bracino/bracino/server/README.md

# server

Self-hosted supervision stack — **t520 backend** (HP t520, 192.168.1.215, issue 015 stage A).

Recovery path: `git clone && docker compose up` (after the one-time steps below).

## Design (2026-09-05, settled)

- **Capture chain:** mosquitto → commit service → JSONL. BATCH_ACK is gated on **fsync'd JSONL** only. InfluxDB (stage C) is a *projection*: written by a tailer, never gates acks, always rebuildable from JSONL.
- **Storage, three failure domains:**

| Store | Location | Role |
|---|---|---|
| live JSONL | t520 local `/var/lib/bracino/commit` (30-day rotation, stage C) | source of truth; ack path depends on nothing external |
| JSONL mirror | `/mnt/nas-data2/bracino/commit` (daily rsync) | recovery copy, second failure domain |
| InfluxDB | `/mnt/nas-data1/bracino/influx` | queryable store; UI on :8086 for desktop/Grafana |

- **Auth:** single shared MQTT user `bracino` (hashed `passwd` file, gitignored; plaintext only in `server/.env` (gitignored) and the gateway's NVS via `/prov`). Plaintext 1883 on the LAN is proportionate; per-user ACLs are the upgrade path.
- **Health:** `bracino/gateway/health` = **commit path only** (broker seen, JSONL writable, heartbeating). Influx gets its own topic in stage C — an Influx failure must never gate ESP-NOW.

## Files

| Path | What |
|---|---|
| `docker-compose.yml` | mosquitto + commit (always); influxdb behind `--profile influx` (stage C) |
| `mosquitto/mosquitto.conf` | broker config: auth required, persistence on (DN004) |
| `mosquitto/passwd` | hashed credentials — **gitignored, generated on host** |
| `commit-service/` | DN005 service + Dockerfile + fake_publisher (bench) |

## t520 bring-up (stage B)

### 0. Prereqs

```bash
git clone git@github.com:bracino/bracino.git ~/bracino && cd ~/bracino/server
findmnt | grep -E 'nas-data[12]'      # both drives durably mounted
ip addr | grep 192.168.1.215          # DHCP reservation live
docker run --rm hello-world
```

### 1. Directory skeleton

```bash
sudo mkdir -p /mnt/nas-data1/bracino/{mosquitto/{data,log},influx/{data,config}}
sudo mkdir -p /mnt/nas-data2/bracino/commit
sudo chown -R 1883:1883 /mnt/nas-data1/bracino/mosquitto
sudo chown -R 1000:1000 /mnt/nas-data1/bracino/influx /mnt/nas-data2/bracino/commit
sudo mkdir -p /var/lib/bracino/commit && sudo chown 1000:1000 /var/lib/bracino/commit
```

### 2. Broker auth

```bash
docker run -it --rm -v "$PWD/mosquitto:/mosquitto/config" eclipse-mosquitto:2 \
  mosquitto_passwd -c /mosquitto/config/passwd bracino
# ↑ -it required: without stdin attach, passwd reads EOF → "Empty password"
sudo chown 1883:1883 mosquitto/passwd
ls -l mosquitto/passwd      # -rw------- ... 1883 1883 — 0600 is what we want
sudo cat mosquitto/passwd   # expect: bracino:$7$… (hash, not plaintext)
# plain `cat` denies you on purpose; only the broker (uid 1883) reads it
```

### 3. Secrets

```bash
cat > .env << 'EOF'
MQTT_USER=bracino
MQTT_PASS=<your password>
EOF
chmod 600 .env
```

### 4. Up + smoke test

```bash
docker compose up -d mosquitto commit
docker compose logs --tail 20 commit     # connected, subscribed
# docker compose auto-loads .env; your shell does not — export first
set -a; . ./.env; set +a
mosquitto_sub -h localhost -t 'bracino/#' -u bracino -P "$MQTT_PASS" -v &
mosquitto_pub -h localhost -t 'bracino/test' -m ping -u bracino -P "$MQTT_PASS"
```

### 5. Daily JSONL mirror (install once)

```bash
( crontab -l 2>/dev/null; \
  echo '17 3 * * * rsync -a --delete /var/lib/bracino/commit/ /mnt/nas-data2/bracino/commit/' ) | crontab -
```

## Gateway provisioning (after stage B)

Flash from the dev VM (`idf.py -p /dev/ttyACM1 flash monitor`), long-press GPIO27 → join `bracino-gateway01`/`bracinoAdmin` → `http://192.168.5.1/prov`: house WiFi, broker `192.168.1.215:1883`, **MQTT user `bracino` + password**. Serial fallback: `u <user> [pass]` (or `u -` to clear). Status page shows the user, never the password.

## Stage C (influx), deployed 2026-09-08

InfluxDB runs behind `--profile influx`; the **tailer** in commit-service
projects the JSONL into it. Facts:

- **Ack path untouched:** the tailer is a daemon thread that reads the
  JSONL and POSTs line protocol to `INFLUX_URL`. Its failures never
  touch watermarks, acks, alarms or the MQTT loop. JSONL stays the
  source of truth; the projection is rebuildable by deleting
  `/var/lib/bracino/commit/influx_tail.json` and restarting (re-tail is
  idempotent — timestamps come from each record's own stamp, so overlap
  overwrites identical points).
- **Gating:** set `INFLUX_TOKEN` in `server/.env` to enable; unset =
  pre-stage-C behavior. `INFLUX_URL` defaults to `http://influxdb:8086`
  (compose DNS); org/bucket default to `bracino`.
- **First run backfills** the whole JSONL (~16k points ≈ 4.7 MB —
  seconds). Bench traffic lands too; boot_session tags separate the
  streams (see 015 record-hygiene note; AMB discount rule in 022).
- **Measurements:** `telemetry` (tags node_type/node_id/boot_session/
  mode; fields t_tpo, t_tpu, t_amb, ct_state, relay_state,
  fault_flags, capture_ms), `event` (tags node_type/node_id/event/
  fault_id), `gw_ambient` (fields t_amb, fault).
- **Health:** `bracino/backend/influx` {ok, last_write_age_s, lines}
  retained, 30 s — commit-path health stays on `bracino/gateway/health`
  and never depends on Influx.
- Note: the GW's ext-ambient channel read −31 °C (misranged) until
  2026-09-06 ~14:49Z; `gw_ambient` before that stamp is junk (see
  issue 022 discussion).

```bash
docker compose --profile influx up -d      # one-time influx deploy (done)
cd ~/bracino/server && git pull && docker compose build commit \
  && docker compose up -d commit           # enable the tailer
```

Grafana runs in the stack (profile `grafana`, port 3000, data on
`/mnt/nas-data1/bracino/grafana`; datasource + starter dashboard
provisioned from `server/grafana/` — first login is `admin`/`admin`,
Grafana forces a password change):

```bash
docker compose --profile grafana up -d      # one-time grafana deploy
```

The desktop can still browse Influx directly at `http://192.168.1.215:8086`.

### Rotation recovery (mv-style rotation)

Deleting, moving, or rotating the JSONL is always safe for the commit
path (per-line open-append-fsync-close; see commit-service README). For
the *projection* the rule is: the tailer treats `size < offset` as a
rotation and re-tails the **new** file from 0 — so a file you `mv` away
(`telemetry.jsonl.old`) is never ingested. If you rotate by `mv`, merge
the old content back into the live file **while commit is stopped** and
force a full re-tail:

```bash
cd ~/bracino/server && docker compose stop commit
cd /var/lib/bracino/commit
cat telemetry.jsonl.old telemetry.jsonl > telemetry.jsonl.merged
wc -l telemetry.jsonl.old telemetry.jsonl telemetry.jsonl.merged  # counts must add up
mv telemetry.jsonl.merged telemetry.jsonl
rm data/influx_tail.json        # force full re-tail; deletion only counts while stopped
cd ~/bracino/server && docker compose start commit
```

Re-POST of already-ingested points is harmless — timestamps come from
the records themselves, so overlap overwrites identical points. Keep
the stopped window short: unacked node batches are retransmitted and
JSONL-deduped; only QoS-1 *events* published during the gap are lost
(clean session), and alarms are retained.

**Verified 2026-09-09:** 4.4 MB rotated `.old` merged, full re-tail
clean, backfill visible in the :8086 UI matching the plotter output.

### Gotchas seen in stage B

- **Bind-mount path auto-created as a directory**: if `docker compose up`
  runs before a mounted file exists (e.g. `mosquitto/passwd`), docker
  creates the missing host path as a root-owned *directory*. Broker then
  fails with `Unable to open pwfile` forever. Fix: `rmdir` it, generate
  the file, `docker compose up -d`.
- **passwd generation needs `-it`**: without stdin attach, `mosquitto_passwd`
  reads EOF → `Empty password`.
- **passwd ownership**: generated as root:0600; chown to the image's
  broker uid (`docker run --rm eclipse-mosquitto:2 id mosquitto`).

## commit-service bench (unchanged)

The VM bench workflow (venv, fake_publisher, layer-1 drills 1–3 results) lives in [`commit-service/README.md`](commit-service/README.md). The service falls back to anonymous MQTT when `MQTT_USER`/`MQTT_PASS` are unset, so drills keep working against an auth-less bench broker.
