bracino/bracino/server/commit-service/README.md

# commit service — DN005 skeleton (issue 015)

Bench phase of the backend pipeline: subscribes gateway telemetry/events,
writes JSONL durably, publishes commit watermarks the gateway's
BATCH_ACK is gated on. Grows into the real DN005 service (Influx write)
later — the JSONL schema is the Influx mapping.

## Files

- `commit_service.py` — subscriber + JSONL writer + watermark/time/health publisher
- `fake_publisher.py` — synthetic DN004 telemetry source (layer-1 test, zero firmware)
- `data/` — runtime output, **gitignored** (`telemetry.jsonl`, `commit_state.json`)

## Run (bench)

```bash
cd server/commit-service
python3 -m venv .venv && . .venv/bin/activate
pip install -r requirements.txt

# terminal 1: broker (if not already running as a service)
#   sudo apt install mosquitto && systemctl start mosquitto

# terminal 2: the commit service
python3 commit_service.py

# terminal 3: watch the watermarks
mosquitto_sub -t 'bracino/gateway/commit' -t 'bracino/gateway/health' -v

# terminal 4: fake node
python3 fake_publisher.py --count 50 --interval 0.2
```

**Log-file hygiene (2026-09-06):** the JSONL is re-opened fresh per line
(the fsync dominates cost, so this is free). Deleting, moving, or
rotating `telemetry.jsonl` is always safe — the next write re-creates
it at the canonical path. Earlier behavior (one held startup handle)
silently orphaned writes when the file was `mv`'d/deleted: acks kept
flowing into an unlinked inode.

On the t520 (no venv; the image already carries fake_publisher + paho):

```bash
cd ~/bracino/server
set -a; . ./.env; set +a
docker compose run --rm commit python fake_publisher.py \
  --count 5 --interval 0.2 --host mosquitto
# --host mosquitto is required: the script defaults to localhost,
# which is not the broker from inside the container.
```

## Layer-1 acceptance (issue 015 drill list)

1. JSONL lines match published samples; watermarks monotonic, last
   watermark == max capture_ms written. **PASSED 2026-09-04** (50 lines,
   0→9800 in monotonic steps).
2. Kill the service mid-stream → watermarks/health stall; restart →
   `commit_state.json` resumes the dedupe cursor; no duplicate lines
   when the publisher re-sends overlapping samples. **PASSED 2026-09-04**
   (kill+restart+replay; one duplicate found and fixed — equality case
   in the skip condition — and the crash-window caveat below recorded).
3. Publisher re-send of already-committed capture_ms → zero new lines,
   zero watermark regression. **PASSED 2026-09-04** (10 replays → 0
   watermarks, cursor unchanged).

## Known limitation: crash window

The JSONL line and the dedupe cursor are two separate files. A kill (or
power cut) between `fsync(jsonl)` and `fsync(commit_state.json)` leaves a
sample written but the cursor behind — a later replay writes that sample
again. Accepted: the final Influx write is idempotent on
(node_type, node_id, boot_session, timestamp), so the duplicate is
absorbed at ingestion; JSONL analysis can dedupe on the same key.
Fixing it properly would require one atomic commit for both files
(single store), which is exactly the complexity the streaming design
refuses to take on.
