bracino/bracino/docs/STATUS.md

# Status

**As of:** 2026-09-11  
**Phase:** 1 — prototype (BBU control node + WiFi gateway)  
**Repo:** https://github.com/bracino/bracino

## Summary

Hardware definition for the module prototype is written (ADR 001, KiCad **v0.08**). The **protoboard is soldered to v0.08** and has passed the same I/O tests as the breadboard. `firmware/node-bbu` runs the offline loop ([DESIGN_NOTE_002](DESIGN_NOTE_002_bbu_control_loop.md)): boots **Manual**, `auto` / `sim` / `halt` on the desk. Human-reported **desk `sim` walk-through passed** (2026-08-22). Human-reported (2026-08-25): dummy **AC load** validated; NTC ice/boil two-point; USB safety block fabricated; TFT+encoder on breadboard (glyphs/flicker fixed). Human-reported (2026-08-26): landscape/SPI2/ISR image **loads and runs**; encoder is **much better**; doubled 6×8 font is **unacceptable**. Human-reported (2026-08-27): TFT+encoder **on the protoboard**; Modern DOS 8×16 **readable**. Human-reported (2026-08-28): UI menus **usable** — rotate/click/hold OK; System Data / Control Program / etc. navigate; WARN amber correct (BGR palette). Issue **010 closed**. **009 closed:** Auto-start on real wells observed. ESP-NOW client evidenced (011/013 closed). MQTT and compose stack: live since 015 stage B (see below).

**ESP-NOW wire bring-up (closed 2026-09-01, issues 011 + 013):** the DN003 client is implemented in `firmware/node-bbu` (behind the `comms_enabled` NVS flag, default off — radio never in the pump path) and validated end-to-end on the desk against the throwaway bench master `firmware/bench-espnow-master` (the real `firmware/gateway` stays untouched per DN004). Proven: HELLO → HELLO_ACK+TLV time, CONFIG_GET/DESC (2 fragments), TELEMETRY_BATCH → BATCH_ACK stop-and-wait with watermark trim, sane UTC, epoch-less TX gate, overnight 11 h accumulation + 42 s drain (3928 samples, 7 decim passes), 20% frame-loss retransmit, unreachable→rescan on the cached channel in tens of ms. Wire defects found and fixed during bring-up: 11 B vs 12 B sample, scan bind-race, pinned peer channel, 10 s rest before first scan. Adjacent-channel leakage at cm desk range ~10% (ch 5↔6) — bench-only, self-heals. Evidence: [013](../issues/closed/013-bench-gateway-harness.md).

Issue **010 closed**. **009 closed 2026-09-01:** Auto-start on the real wells observed (pump ON when TPO fell below threshold); charge-stop not waited on the plant (desk `sim` + unit tests cover that path). MQTT and compose stack not started. First boiler-room hookup was inconclusive — the node's contact closes a **230 VAC coil line** (earlier ~24 V note was wrong) to an **ABB ECB24-40 contactor** in the breaker box, which switches the pump. Pump ON worked; OFF did not (pump kept running). **Root cause found and fixed (2026-09-01):** the RC snubber across our contacts leaked enough to hold the contactor coil; **with the snubber lifted, the pump switches correctly from the node**. **CT confirm-running is a bust by construction** — pump current never flows through node wiring — so the **CT is dropped from the circuit too** (firmware ignores A0, no-CT warning suppressed; blindness is MES-BBU parity by design). Run-confirmation is deferred to the future caldaia monitor node (phase 2: CTs on pump/auger/blower + extra thermals). Install (012) unblocked on the field-image pass. [014](../issues/closed/014-hidden-second-relay-snubber.md) closed.

**012 field-image pass complete (2026-09-02, bench-walked):** boot-mode persistence (mode + Manual coil state in NVS, written only on human/commanded paths; bench-verified incl. factory-fresh erase test), full TFT menus (comms status line, AMB, FIFO depth, DN003 param-table editor with abbreviated names, Diagnostics with the full comms counter block + two-click soft reboot, build-id alias + UTC stamp), persistent pump counters (Up/Pump/Starts in NVS), scan back-off (10 s → 1 min → 10 min cap), and **capture while comms disabled** (buffering is node-side; `comms off` = no radio, not no history — that gap meant a node with comms off from boot recorded nothing). Field reflash proven **from an Android phone** via standalone esptool (recipe in [gotchas](gotchas.md)); NVS survives app-only updates. Hardware **schematic v0.09** committed (encoder A/B/SW caps, PPTC omitted — deploy decision recorded in 012).

**FIELD INSTALL — 2026-09-03.** Bench validation: `b749dc3` passed a 5-min desk check (all menus, param edits). Deploy image `060c88d` cut — `CONFIG_ESP_TASK_WDT_PANIC` stripped (TWDT log-only; a field node must never panic-reboot over a transient) — and pushed to origin **before** install. **Node on the wall, human-confirmed controlling the pump**; parameters persisted through the deploy reflash (params blob v2 migration proven in the field — desk tweaks survived); NTC values sane. Comms OFF (no logger yet — see [015](../issues/open/015-field-logger-gateway.md)); the node has been recording install-day history since it went up (capture-while-disabled). **Full charge-stop cycle observation deferred to the logger (summer — cycles infrequent).**

**015 logger chain field-ready (2026-09-06):** the DN004 backend chain is verified end-to-end on the t520 backend (192.168.1.215) — auth'd mosquitto → commit-service → fsync'd JSONL at `/var/lib/bracino/commit/telemetry.jsonl`, BATCH_ACK gated on the commit watermark, LWT + `bracino/gateway/health` flowing. **Gateway ↔ node ESP-NOW bind proven on real firmware for the first time** (health=0, HEARTBEATs, batches committed 46/46 on first contact). GW fixes shipped during bring-up: `s` now reports fw hash + build id (gen_build_id port from 012), LED error blinks slowed to 200 ms (countable 2.0 s patterns), `raw/drop/last_rssi` rx counters (recv-cb truth, "deaf" vs "rejecting" split), ambient ADC channel corrected (GPIO33 = ADC1_CH5, was silently sampling floating GPIO35), `RANGE` plausibility guard, `ext_amb` + tap mV in `s`. **Issue [018](../issues/closed/018-bench-c3-tx-dead.md)**: a bench C3 transmitted zero radiated power (driver `tx_ok` while two receivers heard nothing) — root cause was depaneling damage nicking antenna + mid-layer trace. Commissioning RF smoke-test (pinned `hel` burst vs golden board, instrumented RX, ≤30 cm) is now **mandatory before any new node's protocol bring-up**. GW deployed to the boiler room 2026-09-06; wall-node reflash (`bdf4a44` + `min_tpo_tpu_delta_c` 1.5) follows once install-day history drains. JSONL volume ≈ 8,600 lines/day ≈ 1.7 MB/day (node 15 s + gw_ambient 30 s; gzips ~10× if the stage-C rotation compresses).

**Control-law bug found in the field (2026-09-04, issue [016](../issues/open/016-pump-no-shutoff-control-law.md)):** the pump did not stop with the boiler already satisfied at 61 °C — the old law put the off-threshold at `setpoint + hysteresis/2` (61.5 °C), *above the boiler's own limit*, and made the stop unreachable once TPO decayed below it (livelock). **Law revised:** hysteresis now applies only on the cooling side — stop at the setpoint (dT satisfied), restart at `setpoint − hysteresis`, plus a peak-tracked cooling backstop for boiler dropout mid-cycle. Host tests + C3 build clean; **flash + field cycle observation pending**.

**Intermittent task-WDT — RESOLVED 2026-09-03.** Two causes named by the armed panic catcher (bench-only `CONFIG_ESP_TASK_WDT_PANIC`) and fixed: (1) encoder GPIO ISR storm — A/B now **polled** on the 5 ms timer, no GPIO interrupt (`f0c0274`); (2) `pdMS_TO_TICKS(5)==0` at `CONFIG_FREERTOS_HZ=100` — `vTaskDelay(0)` yields but doesn't block — now `vTaskDelay(1)` (`5697cef`). Re-soaks clean: ~10 min menu abuse + soft reboots on `5697cef`, 5-min desk check on `b749dc3`. Counter/UI field fixes in `91a5a19` (5-min runtime checkpoint — the "re-zero on flash" root cause; UI-reboot flush; two-click Clear; UTC clock) and `b749dc3` (`ct_confirm_s` removed from the wire registry — id 5 permanently reserved, CONFIG_VER 3, params blob v2). Deploy image ships TWDT **log-only** (`75fc52c`/`060c88d`); panic-catcher recipe kept as a comment in sdkconfig.defaults. Lessons: [gotchas](gotchas.md) + both agent skills.

**Overnight outage drill (2026-09-01, unattended):** gateway off all night while the node ran AUTO — FIFO accumulated to 3928/4096 with 7 decimation passes, loop unaffected (non-blocking contract in the field). Morning drain: `comms off` (FIFO held) → gateway up + epoch → `comms on` → re-anchor + CONFIG_DESC + **3928 samples drained in ~42 s, watermarks monotonic, zero retransmits/malformed, UTC self-consistent end-to-end**; decimation signature (oldest-half halving) matches the DN003 policy. Frame-loss drill and scan-on-unreachable fix confirmed the same day. Logs: [013](../issues/closed/013-bench-gateway-harness.md).

CT no-current / unusable is **warning only** — stay on the standard algorithm (same blindness as the old MES-BBU, plus a notice). `TPO_ONLY` is for TPU faults only. Since 2026-09-01 the CT is **not fitted at all** (DN001 rev 2): no CT warnings can fire; run-confirmation is deliberately absent until the caldaia monitor node.

Design contracts settled 2026-08-30: **ESP-NOW wire law** ([DESIGN_NOTE_003](DESIGN_NOTE_003_espnow_node_schema.md)) — implemented and evidenced in `node-bbu` (011/013 closed) — and **gateway design + MQTT contract** ([DESIGN_NOTE_004](DESIGN_NOTE_004_gateway_design.md)), not yet built. DN002 updated: boot-in-last-known-mode + NVS-persisted parameters are field-image requirements (issue 012).

Open design work: [`issues/open/`](../issues/open/). Plan: [`ROADMAP.md`](ROADMAP.md). Kickoff scrap (not maintained): [`project_slug.md`](project_slug.md).

## What works

| Area | State |
|---|---|
| Repo layout + git remote | Solid (phase 1 only) |
| Root README / AGENTS / MIT license | Solid |
| STATUS / ROADMAP / issues notebook | Process solid; this file tracks bench reality |
| Control-node HW definition | **Settled — ADR 001 + KiCad v0.09** (encoder caps, PPTC omitted per deploy decision, CT+snubber dropped). v0.09 exports in-tree; protoboard soldered to v0.08 + hand reworks |
| `node-bbu` firmware | **DEPLOYED to the plant 2026-09-03** — deploy image `060c88d` (TWDT log-only, comms OFF). Loop per DESIGN_NOTE_002; modes **Auto / Manual / Test / Off**; TFT+encoder UI with full DN003 param-table editor, persistent counters (5-min runtime checkpoint), two-click Clear/Reboot, Home UTC clock. WDT saga closed (encoder A/B polled; HZ=100 delay fix). Next: field logger [015](../issues/open/015-field-logger-gateway.md) |
| `gateway` firmware | **Built + deployed 2026-09-06** (015): DN003/DN004 chassis, BATCH_ACK on commit watermark, LWT, status SoftAP + GPIO2 LED, `s` with fw id / raw rx counters / ambient. ESP-NOW bind to the wall node proven end-to-end |
| MQTT topic + payload schema | **Live** — DN004 implemented; auth'd mosquitto on t520, telemetry/events/health/LWT flowing (015 stage B verified 2026-09-05/06) |
| ESP-NOW payload schema | **Settled and evidenced** — [DESIGN_NOTE_003](DESIGN_NOTE_003_espnow_node_schema.md). Implemented in `node-bbu` (011 closed) behind `comms_enabled`; bench harness 013 closed |
| Commit service (MQTT→Influx + watermarks) | **Stage B live on t520** — DN005 skeleton in `server/commit-service/`: JSONL source of truth (fsync-gated acks), commit watermarks, health topic. Stage C (Influx projection + 30-day rotation) open |

## Session 2026-09-07 (flash manifest pending)

- **019 opened**: 05 Sep "leap" forensics → node chip-freeze (~10h54m of
  real time lost, timer included; mains-blip trigger on a 20 µF rail).
  Explanation human-accepted; UPS + bulk-cap deferred to next HW rev.
- **GW fix + status**: `restore_time()` now restores from `epoch_s`
  alone (DN004 amended); GW publishes retained node online/offline
  status on unreach raise/clear.
- **020**: EVENT carries `TLV_EVENT_CAPTURE_MS` (offer-time stamp);
  event queue 8→24; DN003 amended. Rides the node flash.
- **021**: commit-service subscribes node/gateway status → retained
  `bracino/alarm` + optional `NTFY_URL` push. Needs t520 rebuild.
- **026 + 027 (2026-09-11)**: node→gw ESP-NOW *delivery* outages
  diagnosed from the Sep-10/11 record (boot/capture continuity intact;
  charts honest via node_ts backfill) — root-cause hypothesis: gw health
  gate tears down ESP-NOW on a single failed 1 Hz check, node scan
  backoff amplifies into ~40 min naps; the 11:52Z event was a real gw
  WiFi/MQTT stall, whose LWT alarm **silently failed** (payload drift,
  fixed in 027). Measurement-only firmware cut: node LINK_SCAN/LINK_BIND
  ring events, gw-016 status JSON (mode/legs/RSSI/channel, 30 s),
  commit-service alarms on empty-or-online:false + `gateway_back`.
  Fix decision (exit-hysteresis vs standby-ACK) deferred until an outage
  produces its verdict. Flash recipe: ephemera (local) 2026-09-12.
- **Pending field/bench ops:** GW flash (restore_time + status), node
  flash `bdf4a44`-line + `min_tpo_tpu_delta_c`→1.5 + comms ON (field
  default; NVS-persisted so off stays off), tel=15; commit-service
  rebuild on t520. Flash targets: rebuild both trees post-commit.
| Relay drive (5 V module vs GPIO10) | **OK on protoboard** — Q1 2N3904, high = ON. Coil toggles and holds; dummy AC load validated (2026-08-25) |
| CT / current sense | **Dropped from the circuit (2026-09-01)** — [DESIGN_NOTE_001](DESIGN_NOTE_001_ct_binary_only.md) rev 2. Bench was boolean-only and reliable (tables below); plant makes it moot: the contact closes a 230 VAC contactor coil (ABB ECB24-40), pump current never crosses node wiring. A0 ignored by firmware (`CT_FITTED 0`), telemetry `ct_state=NOT_FITTED`, no-CT warning suppressed. Snubber also removed (plant-proven). Run-confirmation returns via the phase-2 caldaia monitor node |
| NTCs (A1–A3) | **°C in firmware** (β=3950). Ice ~0.4 °C (770 mV); boil ~100 °C (3083 mV) was FAULT on the old 95 °C cap — conversion now −5–110 °C. Open/short = FAULT |
| 12 V / buck vs USB | **Heartbeat OK on external 5 V** (USB unplugged). J7 is a **5 V-only** jumper (buck VO ↔ board +5 V). USB-blocking holder **fabricated** |
| `server/` docker compose + provisioning | **Running on t520** — `git clone && docker compose up` recovery path (mosquitto + commit; influx behind profile). README has bring-up recipe + bench traps |
| Grafana dashboards | **Starter live on t520** (2026-09-10) — `bracino-grafana`, port 3000, datasource + `bbu-overview` dashboard provisioned from git (TPO/TPU, relay timeline, GW ambient). Events/annotations + custom panel work in progress |
| Node-RED flows | **Not started** (deliberately — stage C) |
| Influx backup/retention policy | **Outlined** (three failure domains: live JSONL + NAS mirror + Influx; rotation stage C), not deployed |

## Bench — do not overclaim

Verified by hand on the **breadboard** (2026-08-14 / 15), then repeated on the **v0.08 protoboard** (human-reported 2026-08-22). Agents have not re-run these.

Breadboard (2026-08-14 / 15):

- 12 V → buck 5 V → MCU 3.3 V rails.
- ADS1115 at 0x48 on GPIO7 SDA / GPIO6 SCL.
- ZMCT103C on 3.3 V, A0, pot **2 turns CCW** from full CW: relay off ≈ 0 mV rms; relay on / no load ≈ 37 mV; ~0.15 A fan ≈ 175 mV. Dryer currents 0.84–7.8 A are **not** monotonic — do not treat A0 as amperes.
- Q1 on GPIO10; module VCC **5 V**. Coil toggles as commanded and holds. Later: switches bench loads.
- NTC dividers (TH1/R4 → A1, TH2/R5 → A2, TH3/R6 → A3). Lab ambient **28 °C**: mid **1758–1769 mV**, rms **0**, pp **0–1 mV**. Warming **raises** mid; cooling **lowers** it. Direction matches NTC from +3.3 V to the tap, 10 kΩ to GND.
- A3 faults: **open** mid **13 mV**; **short** mid **3283 mV**; restore **1762–1769 mV**. Firmware must treat those rails as **fault**, not °C.
- CT: ~0.13 A → A0 rms **168–173 mV**; contacts closed / no load → **37–38 mV**. `mid` still walks. Same gap as 2026-08-14 ([DESIGN_NOTE_001](DESIGN_NOTE_001_ct_binary_only.md)).

Protoboard CT sweep (2026-08-22, relay ON, `s` n=64): no-load **37–38 mV** rms; 0.13 A **176–180**; 0.86 A **175–177**; 2.0 A **168** (below the fan); 3.6 A **240–242**; 4.1 A **233–236** (`mid` walks); 7.8 A **289–295**; return to no-load **37–38**. Loaded vs not is clear. Amperes are not. Stay boolean. *(Superseded 2026-09-01: CT removed from the circuit for field revs — DN001 rev 2. Bench history only; `s0` can still burst A0 by hand.)*
- Tank **operating** range **18–95 °C** stays on this 10 kΩ/10 kΩ divider (~0.76–3.1 V from ice to boil), clear of open/short. Keep the divider. ADS internal ref is not ratiometric to 3.3 V; ΔT mostly cancels rail drift.
- On-board WS2812 on GPIO10 stays dark; leave unused. Do not put a webserver on `node-bbu`. Gateway / ESP-NOW / backend wait until the offline loop is boring.

Protoboard (human-reported 2026-08-22): soldered to KiCad **v0.08**. Same I/O suite passed: heartbeat on external 5 V, relay switches loads, coil and NTCs read reasonable values. PPTC (F1) not populated; space left. ADS1115 ADDR and ALRT pins not brought out (module onboard pulls; float is fine). AC side (terminal block, relay, snubber) sits on a 1 mm plastic isolation pad.

KiCad **v0.08** BOM / netlist (do not treat `.kicad_sch` as the agent-readable source):

- **Q1** 2N3904: GPIO10 (`RELAY`) → **R1** 2 kΩ → Q1 base; Q1 collector = module `IN`; Q1 emitter = GND. Module VCC on **+5 V**. GPIO10 **high** sinks IN (coil **ON**).
- **TH1 / R4** → A1, **TH2 / R5** → A2, **TH3 / R6** → A3. Each NTC from +3.3 V to the tap; each 10 kΩ from the tap to GND.
- **D1 / R7** (2.2 kΩ): GPIO8 heartbeat LED to GND.
- **D2 / R8** (4.7 kΩ): 12 V power LED on the post-Schottky buck VIN. USB must not light it.
- **J7**: 2-pin jumper, **5 V only**. **In** = buck VO (`+5V_VO`) → board `+5 V` (C3 5 V pin included). **Out** = buck isolated from the rail even if 12 V is still on the inlet; USB free. GND unswitched. Mechanical USB-blocking holder **fabricated** (2026-08-25).
- **F1** PPTC is in the schematic; not fitted on this article.

Human-reported (2026-08-25): current image flashed and working; dummy AC load on the relay validated (CT still binary, reliable for running/not); NTC cables built and tested good; sensors potted. Ice water: TPO/TPU/AMB **0.2–0.6 °C** at **760–776 mV**. Boiling: AMB then TPO/TPU climb to **94.8 °C / 3053 mV**, then **FAULT at 3063–3083 mV** — that is ~100 °C hitting the old 95 °C software cap, not a short (short ≈ 3283 mV). TFT LED brighter with **R3 = 100 Ω** (schematic still 220 Ω). Encoder module is fine; bounce was the 5 ms A-edge poll. Human (2026-08-26): ISR rewrite **loads and runs**, encoder **much better**; doubled 6×8 font **rejected**.

Human (2026-08-27): UI moved onto the **protoboard**. Modern DOS 8×16 (CC0, 20×8 grid, col 0 blank) is **readable**, upright, LTR; no right-edge junk. MADCTL stays MY|MV|BGR with software X/Y flip (MX|MV made glyphs worse).

Human (2026-08-28): **010 closed.** Rotate and click acceptable; hold ~0.8 s returns Home; all Selection menus open distinct screens; Control Program Manual + relay ON shows amber **WARN no CT**; live digits stable. Firmware fixes: DMA done-wait (`fa7659f`); full-row blit + independent encoder timer / wall-clock hold (`e454f60`); BGR-aware `COL_RGB565` palette so amber is not deep blue (`ee3e6c3`). Light residual: serial `st` with panel unplugged not re-checked this pass.

Still open on the protoboard: connector / jumper labels, PPTC when stock arrives. Do not put the real BBU pump on this image yet.

Shared ESP-IDF is under `~/projects/share/lib/esp/esp-idf`.

## Known constraints (always true)

- Pump on/off must remain correct with gateway/broker/server **down**.
- No WAN/cloud dependency for heat.
- Secrets never in git (Node-RED flows, compose, firmware sources).
- Shared ESP-IDF lives outside this repo.

## Architecture (current tree)

```text
firmware/node-bbu/         local loop (DESIGN_NOTE_002) + serial / sim + TFT UI
firmware/gateway/          placeholder README
hardware/bbu-controller/   KiCad prototype v0.08 + pin map
server/{mosquitto,nodered,grafana,influx-init}/
docs/STATUS.md ROADMAP.md ADR_001.txt DESIGN_NOTE_001…
docs/CONTEXT/ HW_REFS/     plant notes + datasheets
issues/{open,closed,fixtures}/
```

## Verification

`firmware/node-bbu` builds with:

```bash
. ~/projects/share/lib/esp/esp-idf/export.sh
cd firmware/node-bbu && idf.py build
```

Flash/monitor is a human step (`/dev/ttyACM0` on the C3-Zero; port may drop on reset — retry, do not rebuild from scratch). Monitor quit: **Ctrl+]**. Pull **J7** before plugging USB. No compose stack yet.

## License

MIT — see root `LICENSE`.
