bracino/bracino/issues/open/007-nodered-and-first-dashboard.md

# 007 — Node-RED flow structure and first dashboards

- **Status:** open
- **Type:** task
- **Opened:** 2026-07-26
- **Refs:** `server/nodered/`, `server/grafana/`, related `004`

## Context

Supervisory UI and light logic only. Phone-friendly status; Grafana for history. No pump interlocks in Node-RED.

## Expected

Compose-provisioned baseline; flows.json without secrets; one status view + one Grafana tank/pump panel fed from Influx.

## Proposal

Defer until MQTT path exists; keep flows reconstructible from git.

## Fix

## Verify
