bracino/bracino/hardware/gateway/gateway_protoype_kicad/gateway_protoype.kicad_sch

## KiCad design hardware/gateway/gateway_protoype_kicad/gateway_protoype.kicad_sch (2026-09-08)

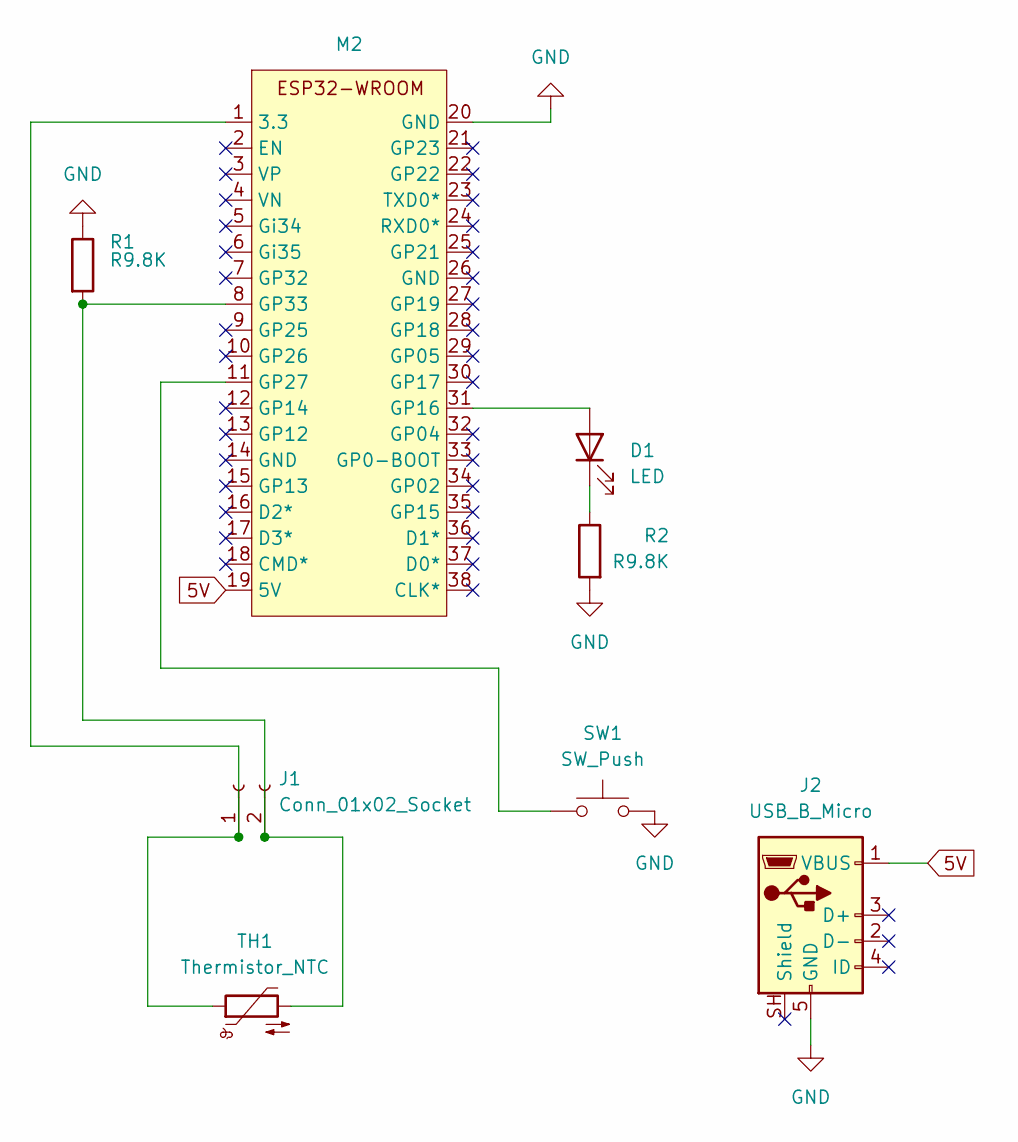
[picture p1: schematic gateway_protoype.kicad_sch]

Parts:
D1: LED
J1: Conn_01x02_Socket
J2: USB_B_Micro
M2: (no value)
R1, R2: R9.8K
SW1: SW_Push
TH1: Thermistor_NTC

Connections:
5V: J2.1 (VBUS), M2.19 (5V)
GND: J2.5 (GND), M2.20 (GND), R1.1, R2.2, SW1.2
unnamed: D1.1 (K), R2.1
unnamed: D1.2 (A), M2.31 (GP16)
unnamed: J1.1, M2.1 (3.3), TH1.1
unnamed: J1.2, M2.8 (GP33), R1.2, TH1.2
unnamed: M2.11 (GP27), SW1.1
