bracino/bracino/hardware/bbu-controller/bbu_controller_prototype_kicad/bbu_controller_prototype.kicad_sch

## KiCad design hardware/bbu-controller/bbu_controller_prototype_kicad/bbu_controller_prototype.kicad_sch (2026-09-02)

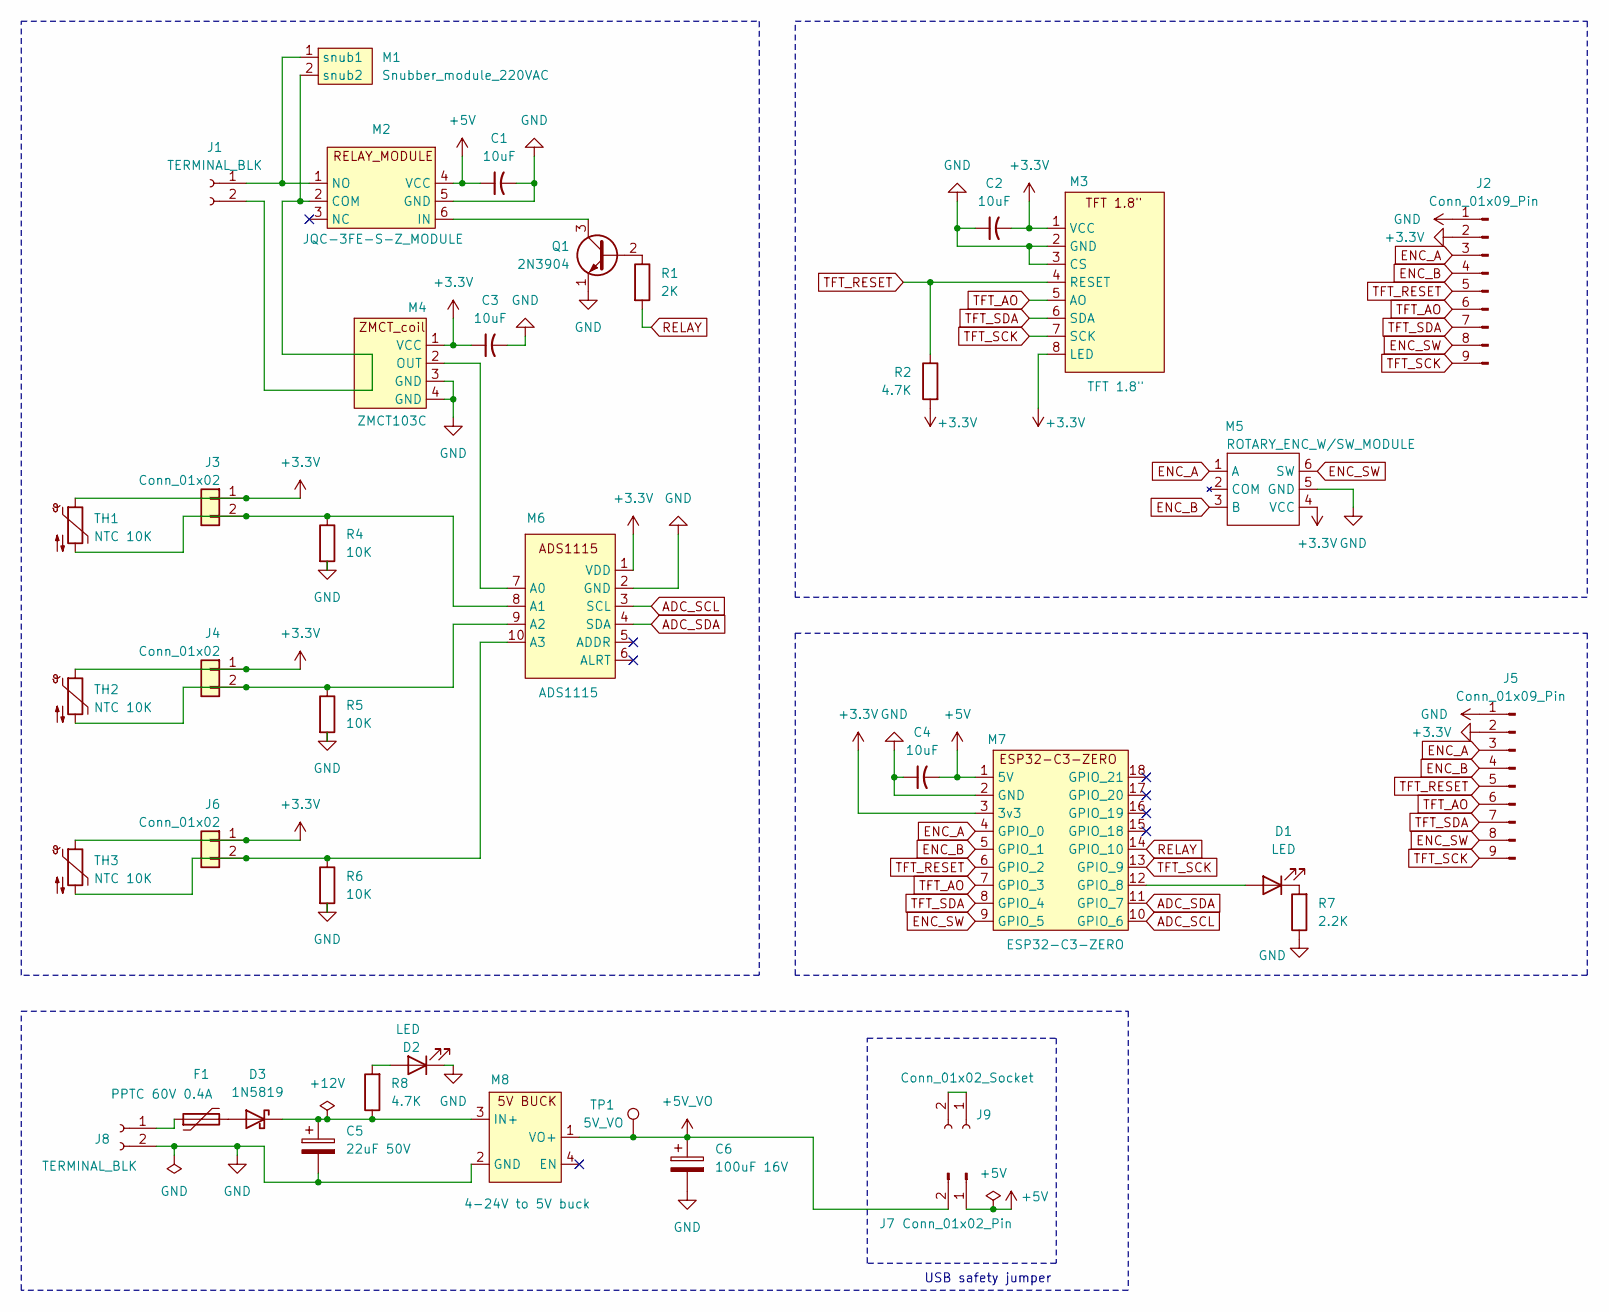
[picture p3: schematic bbu_controller_prototype.kicad_sch]

Parts:
C1, C2, C3, C4: 10uF
C5: 22uF 50V
C6: 100uF 16V
D1, D2: LED
D3: 1N5819
F1: PPTC 60V 0.4A
J1, J8: TERMINAL_BLK
J2, J5: Conn_01x09_Pin
J3, J4, J6: Conn_01x02
J7: Conn_01x02_Pin
J9: Conn_01x02_Socket
M1: Snubber_module_220VAC
M2: JQC-3FE-S-Z_MODULE
M3: TFT 1.8"
M4: ZMCT103C
M5: ROTARY_ENC_W/SW_MODULE
M6: ADS1115
M7: ESP32-C3-ZERO
M8: 4-24V to 5V buck
Q1: 2N3904; TO-92_Inline
R1: 2K
R2: 4.7K
R4, R5, R6: 10K; R_Axial_DIN0207_L6.3mm_D2.5mm_P10.16mm_Horizontal
R7: 2.2K; R_Axial_DIN0207_L6.3mm_D2.5mm_P10.16mm_Horizontal
R8: 4.7K; R_Axial_DIN0207_L6.3mm_D2.5mm_P10.16mm_Horizontal
TH1, TH2, TH3: NTC 10K
TP1: 5V_VO

Connections:
+3.3V: C2.2, C3.1, J2.2, J3.1, J4.1, J5.2, J6.1, M3.1 (VCC), M3.8 (LED), M4.1 (VCC), M5.4 (VCC), M6.1 (VDD), M7.3 (3v3), R2.2, TH1.1, TH2.1, TH3.1
+5V: C1.1, C4.2, J7.1, M2.4 (VCC), M7.1 (5V)
+5V_VO: C6.1, J7.2, M8.1 (VO+), TP1.1
ADC_SCL: M6.3 (SCL), M7.10 (GPIO_6)
ADC_SDA: M6.4 (SDA), M7.11 (GPIO_7)
ENC_A: J2.3, J5.3, M5.1 (A), M7.4 (GPIO_0)
ENC_B: J2.4, J5.4, M5.3 (B), M7.5 (GPIO_1)
ENC_SW: J2.8, J5.8, M5.6 (SW), M7.9 (GPIO_5)
GND: C1.2, C2.1, C3.2, C4.1, C5.2, C6.2, D2.1 (K), J2.1, J5.1, J8.2, M2.5 (GND), M3.2 (GND), M3.3 (CS), M4.3 (GND), M4.4 (GND), M5.5 (GND), M6.2 (GND), M7.2 (GND), M8.2 (GND), Q1.1 (E), R4.2, R5.2, R6.2, R7.1
unnamed: C5.1, D3.1 (K), M8.3 (IN+), R8.1
unnamed: D1.1 (K), R7.2
unnamed: D1.2 (A), M7.12 (GPIO_8)
unnamed: D2.2 (A), R8.2
unnamed: D3.2 (A), F1.2
unnamed: F1.1, J8.1
unnamed: J1.1, M1.1 (snub1), M2.1 (NO)
unnamed: J1.2, M1.2 (snub2), M2.2 (COM)
unnamed: J3.2, M6.8 (A1), R4.1, TH1.2
unnamed: J4.2, M6.9 (A2), R5.1, TH2.2
unnamed: J6.2, M6.10 (A3), R6.1, TH3.2
unnamed: J9.1, J9.2
unnamed: M2.6 (IN), Q1.3 (C)
unnamed: M4.2 (OUT), M6.7 (A0)
unnamed: Q1.2 (B), R1.1
RELAY: M7.14 (GPIO_10), R1.2
TFT_AO: J2.6, J5.6, M3.5 (AO), M7.7 (GPIO_3)
TFT_RESET: J2.5, J5.5, M3.4 (RESET), M7.6 (GPIO_2), R2.1
TFT_SCK: J2.9, J5.9, M3.7 (SCK), M7.13 (GPIO_9)
TFT_SDA: J2.7, J5.7, M3.6 (SDA), M7.8 (GPIO_4)

Notes on the sheet:
USB safety jumper
