bracino/bracino/firmware/node-bbu/main/control.h

#pragma once

#include <stdbool.h>
#include <stdint.h>

#include "ntc.h"
#include "params.h"

#define BBU_TPU_INVERT_SLACK_C 1.0f
#define BBU_TEST_LIMIT_S       (15 * 60)
#define BBU_STUCK_CONFIRM_S    2
/* No-CT warn window. Not a parameter anymore: the CT was dropped from the
 * circuit (014, DN001 rev 2), the warn path is dead on CT-less hardware,
 * and the value is fixed for the bench/host-test path only. */
#define BBU_NOCT_CONFIRM_S     10

typedef enum {
    BBU_MODE_MANUAL = 0,
    BBU_MODE_AUTO,
    BBU_MODE_TPO_ONLY, /* Auto with TPU ignored — not a user mode */
    BBU_MODE_TESTING,
    BBU_MODE_FAULT,    /* TPO unusable — not a user mode */
    BBU_MODE_OFF,
} bbu_mode_t;

enum {
    BBU_LAST_NONE = 0,
    BBU_LAST_TPO  = 1,
    BBU_LAST_TPU  = 2,
};

typedef enum {
    BBU_CYCLE_IDLE = 0,
    BBU_CYCLE_RUNNING,
} bbu_cycle_t;

enum {
    BBU_EVT_MODE       = 1u << 0,
    BBU_EVT_CYCLE      = 1u << 1,
    BBU_EVT_WARN_STUCK = 1u << 2,
    BBU_EVT_WARN_MAX   = 1u << 3,
    BBU_EVT_TEST_END   = 1u << 4,
    BBU_EVT_WARN_NOCT  = 1u << 5,
};

typedef struct {
    ntc_sample_t tpo;
    ntc_sample_t tpu;
    bool ct_fitted;   /* false = no CT in circuit; warn_noct suppressed */
    bool ct_present;
    uint32_t dt_s;
} bbu_sense_t;

typedef struct {
    bbu_mode_t mode;
    bbu_mode_t user_mode; /* Auto / Manual / Test / Off only */
    bbu_cycle_t cycle;
    bool relay_on;
    bool warn_stuck;
    bool warn_maxrun;
    bool warn_noct;
    uint32_t mode_s;
    uint32_t cycle_s;
    uint32_t run_s;
    uint32_t total_run_s;
    uint32_t starts;
    uint32_t stuck_s;
    float peak_tpo_c;   /* highest TPO this RUNNING cycle (016 cooling stop) */
    uint8_t tpo_only_src; /* bit0 TPU (TPO_ONLY). CT is warn-only. */
    uint8_t last_fault;
} bbu_ctrl_t;

/* DN002 boot persistence: fired ONLY from human/commanded paths
 * (request_mode / manual_relay — serial, UI, or PARAM_SET), never from
 * Auto loop transitions (the cycle is re-derived from sensors at boot).
 * TESTING is never reported. main.c writes the NVS boot blob; control.c
 * stays NVS-free so host tests run bare. */
typedef void (*bbu_persist_fn_t)(bbu_mode_t user_mode, bool relay_on);
void bbu_ctrl_register_persist_cb(bbu_persist_fn_t fn);

/* Fired when stats are reset (bbu_ctrl_clear_stats) so the caller can
 * persist the cleared values. Also reused as a pre-reboot flush. */
typedef void (*bbu_stats_fn_t)(uint32_t total_run_s, uint32_t starts);
void bbu_ctrl_register_stats_cb(bbu_stats_fn_t fn);

/* Ask the registered callback to persist counters NOW (UI soft reboot,
 * periodic checkpoint). No-op if no callback registered. */
void bbu_ctrl_save_stats(bbu_ctrl_t *c);

void bbu_ctrl_init(bbu_ctrl_t *c);
const char *bbu_mode_name(bbu_mode_t m);
const char *bbu_cycle_name(bbu_cycle_t cy);

/* User commands. Manual/Test keep the coil; Auto/Off start IDLE. */
void bbu_ctrl_request_mode(bbu_ctrl_t *c, bbu_mode_t mode);
void bbu_ctrl_manual_relay(bbu_ctrl_t *c, bool on);
void bbu_ctrl_clear_stats(bbu_ctrl_t *c);

/* One control tick. Returns a bitmask of BBU_EVT_*. */
uint32_t bbu_ctrl_tick(bbu_ctrl_t *c, const bbu_sense_t *s, const bbu_params_t *p);
