bracino/bracino/firmware/gateway/main/amb.c

/* amb.c — exterior ambient NTC on GPIO33 = ADC1_CH5 (issue 015, low
 * priority; 2026-09-06 fix: was configured on ADC_CHANNEL_7, which on
 * ESP32 is GPIO35 — a floating input-only pin. The wired GPIO33 divider
 * read ~2.0 V ≈ 26 °C on a DVM while the firmware published −31.3 °C
 * from the floating ghost channel. GPIO33 is ADC1_CH5 (ADC1, since ADC2
 * cannot sample while WiFi is up).
 *
 * Divider (bench-proven with an Arduino sketch, human 2026-09-04):
 *
 *     3.33 V (measured rail)
 *       |
 *      NTC (10k-class, beta 3950)
 *       |
 *       +---- GPIO33 (tap -> ADC)
 *       |
 *     9810 ohm (measured)
 *       |
 *      GND
 *
 * Warming raises tap voltage — same topology/polarity as the node NTCs.
 *
 * PLACEMENT (2026-09-06 bench finding): the bead must be thermally free
 * of the gateway PCB — on pigtails, off the board surface. A bead flat
 * on/near the powered board read ~35 °C in a ~28 °C room (board heat);
 * finger test moved it only 2.3 °C, confirming thermal anchoring to the
 * board mass. At wall mount the bead must see ambient air, not the
 * enclosure wall. The conversion chain itself verified honest against a
 * DVM (second batch NTC: R25 9.83 kΩ, β 3990 — within 0.1 °C of the
 * firmware anchor at the same tap voltage).
 *
 * IMPORTANT anchor: the Arduino sketch proof measured R_ntc ≈ 8.11 kΩ at
 * 27 °C — but the DVM ice/boil two-point (31.9 kΩ @ 0.8 °C, 686 Ω @
 * 99.0 °C) gives beta ≈ 3986 and R(25 °C) ≈ 9.8 kΩ: a normal 10 k-class
 * part. The sketch's low reading was the uncalibrated ADC chain
 * over-reading the tap ~6 % (predicted tap 1.72 V, sketch saw 1.82 V).
 * So the conversion anchors on the DVM pair, not the ADC-derived one.
 * Residual error is the divider/ADC chain itself — check the status
 * page reading against a reference thermometer on the wall mount.
 *
 * Publishes every 30 s to bracino/gateway/telemetry (DN004 addendum:
 * gateway-local measurements, QoS 0, non-retained). Not node-batch data —
 * no BATCH_ACK/watermark involvement; dedupe downstream is on gw_ts.
 * Faults (open/short) are reported in-band, never a garbage temperature.
 */
#include <math.h>
#include <stdio.h>
#include <string.h>
#include <time.h>

#include "esp_adc/adc_cali.h"
#include "esp_adc/adc_cali_scheme.h"
#include "esp_adc/adc_oneshot.h"
#include "esp_timer.h"

#include "freertos/FreeRTOS.h"
#include "freertos/task.h"

#include "amb.h"
#include "gw.h"
#include "bracino_log.h"

#define PIN_NTC        GPIO_NUM_33   /* = ADC1_CH5 on ESP32 — see header */
#define V_RAIL         3.33f      /* measured on this board */
#define R_FIXED        9810.0f    /* measured */
#define R0_OHM         9797.0f    /* from DVM two-point (see header) */
#define T0_C           25.0f
#define BETA           3986.0f    /* from DVM ice/boil two-point */
#define SAMPLE_PERIOD_S 30
#define NUM_SAMPLES    64

/* fault thresholds on tap voltage (NTC high side) */
#define V_SHORT        3.25f      /* tap ~ rail: NTC ~0 ohm (or fixed R open) */
#define V_OPEN         0.05f      /* tap ~ 0: NTC open / broken lead */

static adc_oneshot_unit_handle_t s_unit;
static adc_cali_handle_t s_cali;
static volatile float s_temp_c;
static char s_fault[8];            /* "" = ok */
/* last sample + conversion regardless of fault — the serial 's' line
 * shows these so RANGE flags come with the numbers that earned them */
static volatile int s_last_mv = -1;
static volatile float s_last_t_c;

const char *amb_fault(void) { return s_fault[0] ? s_fault : NULL; }

float amb_temp_c(void) { return s_temp_c; }

void amb_diag(int *mv, float *t_c)
{
    *mv = s_last_mv;
    *t_c = s_last_t_c;
}

static bool adc_read_avg_mv(int *out_mv)
{
    int raw = 0;
    for (int i = 0; i < NUM_SAMPLES; i++) {
        int r;
        if (adc_oneshot_read(s_unit, ADC_CHANNEL_5, &r) != ESP_OK) {
            return false;
        }
        raw += r;
        vTaskDelay(pdMS_TO_TICKS(2));
    }
    raw /= NUM_SAMPLES;

    if (s_cali) {
        int mv;
        if (adc_cali_raw_to_voltage(s_cali, raw, &mv) == ESP_OK) {
            *out_mv = mv;
            return true;
        }
    }
    /* no eFuse calibration on this board: rail-referenced fallback */
    *out_mv = (int)((float)raw * V_RAIL / 4095.0f * 1000.0f);
    return true;
}

static void convert(int mv, float *temp_c, const char **fault)
{
    float v = mv / 1000.0f;
    *fault = NULL;
    if (v >= V_SHORT) {
        *fault = "SHORT";
        return;
    }
    if (v <= V_OPEN) {
        *fault = "OPEN";
        return;
    }
    float r_ntc = R_FIXED * (V_RAIL - v) / v;
    float t_k = 1.0f / (1.0f / (T0_C + 273.15f) +
                        logf(r_ntc / R0_OHM) / BETA);
    *temp_c = t_k - 273.15f;
    /* implausible reading = wiring/radio fault, not weather (018 lesson:
     * a floating tap above V_OPEN converts to ~-31 °C and passed as
     * valid) */
    if (*temp_c < -20.0f || *temp_c > 60.0f) {
        *fault = "RANGE";   /* keep *temp_c — diagnostics show the miss */
    }
}

static void amb_task(void *arg)
{
    (void)arg;
    int mv = 0;
    for (;;) {
        if (adc_read_avg_mv(&mv)) {
            const char *f = NULL;
            float t = 0.0f;
            convert(mv, &t, &f);
            s_last_mv = mv;
            s_last_t_c = t;
            if (f) {
                strncpy(s_fault, f, sizeof(s_fault) - 1);
            } else {
                s_fault[0] = '\0';
                s_temp_c = t;
            }

            if (gw_time_valid() && gw_broker_up()) {
                char ts[32], fj[12], json[160];
                /* fault strings are fixed internal names — safe to inline */
                snprintf(fj, sizeof(fj), f ? "\"%s\"" : "null", f ? f : "");
                time_t sec = time(NULL);
                struct tm tm;
                gmtime_r(&sec, &tm);
                strftime(ts, sizeof(ts), "%Y-%m-%dT%H:%M:%SZ", &tm);
                snprintf(json, sizeof(json),
                         "{\"t_amb\":%.1f,\"fault\":%s,\"gw_ts\":\"%s\"}",
                         (double)s_temp_c, fj, ts);
                gw_mqtt_publish("bracino/gateway/telemetry", json, 0, false);
            }
        }
        vTaskDelay(pdMS_TO_TICKS(SAMPLE_PERIOD_S * 1000));
    }
}

void amb_start(void)
{
    const adc_oneshot_unit_init_cfg_t unit_cfg = {
        .unit_id = ADC_UNIT_1,
        .ulp_mode = ADC_ULP_MODE_DISABLE,
    };
    ESP_ERROR_CHECK(adc_oneshot_new_unit(&unit_cfg, &s_unit));

    const adc_oneshot_chan_cfg_t chan_cfg = {
        .atten = ADC_ATTEN_DB_12,
        .bitwidth = ADC_BITWIDTH_DEFAULT,
    };
    ESP_ERROR_CHECK(adc_oneshot_config_channel(s_unit, ADC_CHANNEL_5,
                                               &chan_cfg));

    /* eFuse two-point calibration if this chip has it; NULL otherwise
     * and the rail-referenced fallback applies */
    if (adc_cali_create_scheme_line_fitting(
            &(adc_cali_line_fitting_config_t){
                .unit_id = ADC_UNIT_1,
                .atten = ADC_ATTEN_DB_12,
                .bitwidth = ADC_BITWIDTH_DEFAULT,
            },
            &s_cali) != ESP_OK) {
        s_cali = NULL;
        TLOG("amb: no adc line-fitting calibration — rail-referenced\n");
    }

    s_fault[0] = '\0';
    s_temp_c = 0.0f;
    xTaskCreate(amb_task, "amb", 8192, NULL, 1, NULL);
}
