bracino/bracino/firmware/node-bbu/main/comms.h

/*
 * comms.h — ESP-NOW client per DESIGN_NOTE_003 (issue 011).
 *
 * Compiled into every node image; inert until comms_enabled is set (NVS,
 * serial `comms on`, later the UI menu per 012). Control loop feeds
 * samples via comms_offer_sample() — an enqueue, never I/O (non-blocking
 * radio contract). All radio work lives in the comms task.
 */
#pragma once

#include <stdbool.h>
#include <stdint.h>
#include <stddef.h>

/* One captured telemetry sample (wire struct + node-side capture stamp). */
typedef struct {
    uint8_t  mode_w;      /* wire mode: BBU_MODE_W_* */
    uint8_t  relay_state; /* 0/1 */
    uint8_t  ct_state;    /* BBU_CT_STATE_* (3 = NOT_FITTED, issue 014) */
    int16_t  t_tpo_x10;
    int16_t  t_tpu_x10;
    int16_t  t_amb_x10;
    uint8_t  fault_flags; /* BBU_FAULT_* bits */
} comms_sample_t;

/* Hooks for params that live outside params.c (ids 8/9/10/11: user mode,
 * manual relay, comms enable, sample period). Registered by main.c; return
 * false on rejection (range). Same validated setter path as the local UI. */
typedef struct {
    bool (*set)(uint8_t param_id, int32_t value);
    bool (*get)(uint8_t param_id, int32_t *out_value);
} comms_param_hooks_t;

/* Load NVS identity/flags, allocate FIFO, create comms task (idle until
 * enabled). Never blocks the caller. */
void comms_init(void);

bool comms_enabled(void);

/* 023: boot_session is a monotonic per-node counter (first boot = 1),
 * NVS-persisted in the comms namespace. Replaces the old esp_random
 * tags whose random collisions poisoned record provenance. Wraps at
 * 255 → 1 (benign at node reboot frequency — see DN003 / issue 023).
 * Reseed after an erase_flash: comms_set_boot_id_next(N) makes the
 * NEXT boot report N (running boot keeps its id); exposed as serial
 * / PARAM_SET param "boot_id" (id 12) — post-erase runbook step. */

/* Enable/disable the comms path. Persists in NVS. Enabling wakes the
 * comms task (radio comes up lazily); disabling stops all transmission. */
void comms_enable(bool on);

/* Called ~1 Hz from the monitor task. Cadence-gated inside (default 15 s);
 * samples are buffered regardless of gateway reachability. */
void comms_offer_sample(const comms_sample_t *s);

/* Best-effort async event (EVENT_FAULT_*, EVENT_PARAM_CHANGED). Queued and
 * sent when the gateway is reachable; dropped + counted during outage. */
void comms_offer_event(uint8_t event_id, const uint8_t *value, uint8_t len);

/* Encode a param's raw value to its wire form (type from the params
 * descriptor table). Returns bytes written (1/2/4) or 0 on unknown id. */
size_t comms_encode_param_value(uint8_t param_id, int32_t raw, uint8_t *out);

/* Bench/status (serial). */
void comms_status_print(void);

/* UI snapshot (012): small POD read for TFT menus; benign racy.
 * 'link' summarizes the Home status line: OFF = disabled, SCAN = enabled
 * but not bound/anchored, OK = enabled and anchored. */
typedef struct {
    bool enabled;
    bool link_ok;      /* enabled && anchored */
    uint8_t channel;
    bool bound;
    bool anchored;
    uint32_t epoch_s;  /* last anchor, 0 = never */
    uint16_t fifo, fifo_cap;
    uint8_t boot_session; /* changes on every reboot — GW uses it to detect */
    uint32_t fails, rx, tx_ok, tx_fail, retrans, decim, ev_sent;
    uint8_t gw[6];
    uint32_t utc_s; /* current UTC (anchor + elapsed); 0 = never anchored */
} comms_ui_t;
void comms_ui_snapshot(comms_ui_t *out);
void comms_bench_hello_burst(uint8_t ch, int count); /* bench: fixed-ch HELLO burst */
bool comms_set_ident(uint8_t node_type, uint8_t node_id); /* NVS-persisted */
void comms_set_sample_period_s(uint32_t s); /* 5..120, default 15; NVS */
uint32_t comms_sample_period_s(void);
bool comms_set_boot_id_next(uint8_t next); /* 023: 1..255; NVS; next boot */
uint8_t comms_boot_session(void);          /* 023: current boot's id */
bool comms_ring_resize(uint16_t samples); /* bench: reallocates EMPTY ring */
uint8_t comms_node_type(void);
uint8_t comms_node_id(void);
