bracino/bracino/(commit log)

2026-07-26 Phase 1 housekeeping: README, issues notebook, node-bbu rename
    Drop future-node trees; track work like asciiWiring (issues/open|closed).
    Add STATUS/ROADMAP, seed design issues 001–008, align slug and AGENTS.
2026-07-26 MIT license; gateway rename; slug is historical; commit≠push policy
    - Add MIT LICENSE; document in README/STATUS
    - Rename firmware/gateway-wroom → firmware/gateway
    - Move project_slug.md under docs/ with stale-OK banner; stop maintaining it
    - AGENTS: local commits OK when coherent; always ask before GitHub push
    - session-kickoff.md is gitignored local bridge; AGENTS: read if non-empty, then truncate
2026-08-14 Add breadboard bring-up firmware for relay and CT
    Serial commands toggle GPIO10 (active-low relay) and read ADS1115 A0
    so the ZMCT pot can be set on the bench before NTCs or protoboard.
    Relay is forced off at boot. Builds for ESP32-C3 under shared IDF 5.2.
2026-08-14 Record bench outcomes: binary CT, stale docs, relay drive
    Prototype ZMCT path is on/off only (DESIGN_NOTE_001). STATUS/ROADMAP
    and related issues match 2026-08-14 bring-up. ADR 001 notes the 5 V
    relay IN vs GPIO10 problem. Kickoff stays local and gitignored.
2026-08-14 Track KiCad prototype under hardware/bbu-controller
    Leave the project next to the node notes. Commit schematic, PCB
    stub, v0.06 exports, and the pin-map CSV. Ignore .kicad_prl and
    .history so local KiCad state stays out of git.
    [bbu_controller_prototype_kicad-v0.06-BOM.csv, bbu_controller_prototype_kicad.kicad_pcb, bbu_controller_prototype_kicad.kicad_sch, module_pin_mapping_bbu_controller_prototype.csv]
2026-08-22 Record v0.08 protoboard, exports, and bring-up firmware.
    Living docs match the soldered board. KiCad v0.08 plus BOM/netlist/ERC
    replace the v0.06 exports. node-bbu now drives the relay via Q1, samples
    A0–A3, and blinks GPIO8. Issue 009 tracks the offline control loop.
    [bbu_controller_prototype_kicad-v0.08-BOM.csv, bbu_controller_prototype_kicad.kicad_sch]
2026-08-22 Add the offline BBU loop and record the desk sim pass.
    control.c implements DESIGN_NOTE_002 (TPO/TPU start/stop, FAULT,
    TPO_ONLY). NTC °C, prog params, and sim temps are in the bring-up
    image. Host tests and a protoboard sim walk-through passed. CT
    stays binary. Boots MANUAL; no real pump yet.
2026-08-25 Record dummy-load bench progress; CT no-current is warn-only.
    Human 2026-08-25: image flashed, dummy AC load OK, NTC cables built,
    sensors potted/curing, USB block fabricated. Missing or unusable CT
    warns and leaves the TPO/TPU loop alone (old MES-BBU was blind to
    current). TPO_ONLY stays TPU-fault only.
    [control.c, control.h, main.c]
2026-08-25 Add Auto/Manual/Test/Off modes and TFT+encoder menus.
    Drop the name Normal: Auto is the TPO/TPU loop, halt is Off (coil
    stays off). FAULT/TPO_ONLY stay internal overlays. Bit-bang ST7735S
    and encoder on the v0.08 pins, with a MES-style menu tree for
    breadboard validation (issue 010). Setpoint edits remain serial prog.
    [control.c, control.h, enc.c, enc.h, main.c, tft.c, tft.h]
2026-08-25 Fix TFT glyph flip, 2 Hz wipe, and encoder bring-up.
    ST7735 MY was drawing each character bottom-first. Stop wiping every
    row at 2 Hz; cache lines. Home shows enc N; decoder is a debounced
    A-edge. Serial enc prints A/B/SW. Add ST7735 gamma (backlight may
    still be the dim cause).
    [enc.c, enc.h, main.c, tft.c, ui.c]
2026-08-25 Log ice/boil NTC cal; allow -5–110 °C conversion.
    Ice water reads ~0.4 °C at 770 mV (β=3950 holds). Boil at 3083 mV is
    ~100 °C, not a short; the old 95 °C cap was a FAULT. Sensor range is
    now -5–110 °C. Record R3=100 Ω backlight and a bouncy encoder.
    [ntc.h]
2026-08-25 Record TFT breadboard results before push.
    Display OK after glyph/flicker fix; encoder works but bouncy.
2026-08-26 Rewrite TFT/encoder UI: landscape 12x16, SPI2 DMA, ISR quadrature.
    C3 has no PCNT; encoder A/B is a GPIO ISR gray-code table (÷4 detents).
    ST7735 stays on the proven init path, pixels go through esp_lcd SPI IO
    (CS tied GND). Eight-row grid with a 6-row scrolling window. Not
    bench-checked.
2026-08-26 Record 2026-08-26 UI bench: ISR encoder ok, doubled font rejected.
    Human: c9ca914 loads and runs; encoder much better. Next 010 work is a
    real 12x16 bitmap. STATUS/ROADMAP/README/issue 010 updated.
2026-08-27 Replace doubled 5x7 font with Modern DOS 8x16 (1:1).
    Switch landscape grid to 20x8 cells. Drop FONT5X7 pixel-stretch;
    blit CC0 Modern DOS 8x16 row-major glyphs directly. Diag FW label
    updated. SPI2 DMA path and 8-row UI unchanged.
    [tft.c, tft.h, ui.c]
2026-08-27 Fix ST7735 MY origin: upright glyphs, header at top.
    Landscape rewrite dropped the 1a0b045 bottom-first glyph order.
    Restore it for FONT8X16, and invert Y in window() so UI row 0
    maps to the visual top under MADCTL MY.
    [tft.c]
2026-08-27 Unmirror landscape TFT: flip X in window, XSTART 0.
    With MY|MV the glass also ran right-to-left. Mirror X like Y, store
    glyph columns right-first so letters stay upright, and drop XSTART so
    20-column rows no longer clip one character into off-screen GRAM.
    [tft.c]
2026-08-27 Use ST7735 MX|MV landscape; drop software axis flips.
    Adafruit rotation 3 matches the protoboard origin. Glyphs go
    top-left first. Restores green-tab XSTART 1 so 20-column rows
    should not clip a character into off-screen GRAM.
    [tft.c]
2026-08-27 Revert "Use ST7735 MX|MV landscape; drop software axis flips."
    This reverts commit 3d165088f2e077158365c26de42c6a664ad03422.
    [tft.c]
2026-08-27 Blank TFT column 0; start row text at column 1.
    Leave the clipped leftmost cell as space. Menu strings fit in 19
    columns. Reverts the TEXT_X 8 inset (same idea, no on-glass change).
    [tft.c, tft.h]
2026-08-27 Record protoboard 8x16 UI: readable; encoder/click still open.
    Font and orientation accepted on the v0.08 article (col 0 blank).
    010 next is switch debounce and reliable scroll, not more glyphs.
2026-08-28 Fix encoder switch debounce and TFT DMA glyph tearing.
    Switch: require stable level before press/release edges so bounce cannot
    emit a click then still-held hold→Home (menus bouncing back, hold=home
    dead). TFT: wait on_color_trans_done before recycling s_glyph/s_strip —
    esp_lcd DMA was still reading the buffer on the next char (27.9→7.9).
    [enc.c, tft.c]
2026-08-28 UI input: fast row blit + independent encoder timer.
    Per-glyph DMA waits starved enc_poll for hundreds of ms: short clicks
    missed, longer presses hit hold→Home (every submenu looked like Home),
    rotation lagged, hold never reliably reached 0.8 s of poll ticks.
    - tft_text_row: one 160×16 transfer per row (still waits done once)
    - enc: 5 ms esp_timer + wall-clock click/hold; ignore turn while SW down
    - ui: live-refresh only screens that need live values
    [enc.c, enc.h, tft.c, ui.c]
2026-08-28 Fix TFT palette for BGR panel (amber was deep blue).
    MADCTL BGR maps the high RGB565 nibble to blue, so Adafruit-order
    0xFD20 (orange) read as blue. Define colors with R/B swapped so WARN
    and FAULT are amber/red and headers stay cyan.
    [tft.h]
2026-08-28 Close 010: protoboard TFT+encoder UI accepted; refresh STATUS/ROADMAP.
    Human bench 2026-08-28: menus navigate, rotate/click/hold OK, WARN amber.
    Move 010 to closed with Fix/Verify; note st-unplugged as light residual.
2026-08-30 docs: consolidate DESIGN_NOTE_003 ESP-NOW node↔gateway schema
    Replace the two prior DN003 drafts with a single consolidated contract:
    unified telemetry FIFO (single TELEMETRY_BATCH stream), stop-and-wait
    acknowledgment with capture_ms watermark (BATCH_ACK), decimation policy
    under memory pressure, fixed msg_type enum + TLV tag and event registries,
    TIME_SYNC struct, node lifecycle, discovery, ESP-NOW gating, parameters.
    HISTORY flag dropped; DN004 reconciliation noted in open follow-ups.
2026-08-30 docs: consolidate DESIGN_NOTE_004 gateway design
    Replace the two prior DN004 drafts with a single contract: BOOT/WAIT_BACKEND/
    ACTIVE state machine (MQTT-task-owned, asymmetric hysteresis), split registry
    (NVS role table + volatile runtime with per-node time-sync anchors), MQTT
    topic/QoS/retention contract, transactional command pipeline, commit-service
    watermark gating BATCH_ACK (DN005 stub), data-integrity note (DN006 stub),
    button-invoked maintenance AP as an ACTIVE overlay. DN003 declared wire law.
2026-08-30 docs: bench gateway harness spec (013); sync ROADMAP/STATUS/README with DN003+DN004
    File issue 013 — minimal bench gateway spec (2-ESP DN003 wire-contract
    harness: HELLO_ACK+TIME_SYNC, BATCH_ACK-on-log, bench knobs for
    retransmit/decimation drills; explicitly not DN004-conformant).
    Doc review: ROADMAP checks off settled contracts (DN003/DN004), replaces
    Node-RED telemetry-path milestone with commit service (DN005), adds
    011-013 milestones. STATUS reflects settled schemas + install deadline.
    README: Node-RED demoted to optional UI (DN004 commit service owns the
    telemetry path), fix stale ~/projects/shared IDF path to
    ~/projects/share/lib/esp/esp-idf. docs/README lists DN003/004 + DN005/006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
2026-08-31 issues/014: hidden second pump relay found in plant; CT run-confirmation bust; relay/snubber rework needed (012 blocked); DN001 + STATUS notes
2026-08-31 issues/014: investigation plan (snubber lift, coil-voltage bench test, boiler room round 2); ROADMAP: sketch boiler-monitor node for pump CT + temps
2026-08-31 feat: DN003 wire harness — node ESP-NOW client (011) + bench master (013) + shared schema header
    - firmware/shared/bracino_schema: espnow_schema.h canonical registry (node + master include one file)
    - node: comms.{h,c} DN003 client (FIFO, stop-and-wait, scan, TIME_SYNC anchor, epoch-less TX,
    PARAM/CONFIG/EVENT), DN003 param_id table in params.c (one setter path), 1 Hz capture hook,
    bench serial knobs (comms/ident/tel/ring), NVS identity + comms_enabled (default off)
    - bench-espnow-master: minimal gateway harness for WROOM (HELLO_ACK+TIME_SYNC, BATCH_ACK after
    committed-log, CONFIG_GET, canned PARAM_SET, GPIO27 button, BENCH_NO_ACK_S/BENCH_DROP_PCT)
2026-08-31 issues/012: bench hardening notes from bare-module flash (I2C-absent FAULT is expected; WDT case = 010 TFT-unplugged leftover; USB-CDC printf degrades, no field hang)
2026-08-31 bench: RF/channel diagnostics — checked set_channel both sides, master 'k' (driver channel) + 'w' (5 s promiscuous frame count), node logs HELLO send failures
    [comms.c, main.c]
2026-08-31 bench: node 'hel <ch> [n]' fixed-channel HELLO burst; master 'w [sec]' promiscuous frame detail (len + transmitter MAC) — decomposes node-TX vs master-ESP-NOW-RX
    [comms.c, comms.h, main.c]
2026-08-31 bench master: init second-chan field — esp_wifi_get_channel leaves it unwritten when unassociated (was uninitialized stack; decoded as string residue)
2026-08-31 fix: three bench bugs from first live HELLO — master TX-completion mutex/sem conflation (assert killed GW on HELLO), TIME_SYNC tlv layout clobber (garbage node epoch 759442.424 decoded byte-exact), n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
    [comms.c, main.c]
2026-08-31 bench: cmd echo + uptime timestamps both consoles (TLOG/bracino_log.h); flush stale rx queue on comms enable (stale-ACK bind decoded from 013 logs); GW-side liveness warning; archive 013 serial logs
    Log forensics: ch-6 RF works both ways (15 burst HELLOs heard, 30 replies
    received by node); peer-latch theory dead; CONFIG_DESC fragmentation works
    (313 B / 2 frags); original 40-min no-hits = old GW crash-loop on mutex bug.
    Stale-queue bind: hel burst while comms off left 8 queued frames; comms on
    drained them and bound on a minutes-old epoch=0 ACK on cached ch 1 — hence
    'disassociated after epoch'. Flush on enable + echo + timestamps fix the
    operational trap.
    [bracino_log.h, comms.c, main.c]
2026-08-31 bench UX: per-keystroke echo + backspace both consoles (fix blind typing); revert mid-line TLOG pollution (EVENT hex, fault names, registry counters, node r/s separators); disarm CONFIG_DESC reassemb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
    [main.c]
2026-08-31 fix: DN003 bench defects found in 16:48 session logs — telemetry sample was 11 B vs DN003's stated 12 B (add rsv byte; GW malformed-count=1 plen=22 resolved), standalone TIME_SYNC push sent TLV-wrapp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
    [comms.c, espnow_schema.h, main.c]
2026-08-31 fix: node bound one channel behind the gateway during rescan
    scan_attempt bound to chans[i] whenever ANY HELLO_ACK popped from the rx
    queue — including stale ACKs received during the previous channel's dwell
    (master rx task often busy printing sample blocks). Result: bind ch=5/10
    while GW sat on ch 6, every batch send NAK'd, unreachable, rescan loop.
    - tag rx frames with the primary channel at rx time (radio_recv_cb);
    scan only binds when frame channel == current dwell channel
    - flush stale rx frames in go_unreachable() (same class of staleness)
    - master: dedupe retransmitted batches (re-ACK, print '(dup batch ...)'
    instead of re-printing the sample block — also speeds the rx task)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
    [comms.c, main.c]
2026-08-31 fix: unicast TX left on a pinned peer channel while the radio was elsewhere
    node add_gw_peer pinned peer.channel = s_channel; ESP-NOW with a non-zero
    peer channel transmits on that channel — with s_channel wrong (the bind-
    chase bug), every CONFIG_DESC/BATCH left on the wrong channel (NAK) while
    RX worked. Peer channel now 0 = follow the radio.
    Also: set_channel readback on both sides — disabling promiscuous has been
    reported to revert the channel (node retries without toggle and logs);
    master HELLO line now prints the driver's actual channel.
    [comms.c, main.c]
2026-08-31 issue 013: bind-chase addenda — 3 firmware defects fixed, adjacent-channel leakage quantified (~10% at cm range), ch6 ambient load noted
2026-08-31 docs: STATUS/ROADMAP reflect 2026-08-31 ESP-NOW bench bring-up (wire path proven, 3 defects fixed, drills remain)
2026-09-01 issue 013: overnight outage+drain evidence — 3928 samples buffered ~11h, drained clean in ~42s; supersedes Drill A, Drill B remains
    Also un-ignore issues/fixtures/*.log — the global *.log pattern had been
    silently excluding every 'archived' 013 wire-contract log; they are now
    actually committed (bind-chase, ch5-ghost, rf-bisect, stale-queue, overnight pair).
2026-09-01 CT + snubber dropped from the circuit (014 closed): node is MES-BBU-blind by design
    Field findings (2026-09-01): the hidden plant relay is an ABB ECB24-40
    contactor driven through a 230 VAC coil line (not ~24 V); with the RC
    snubber lifted the pump switches correctly from the node, and the contactor
    coil draws too little for the ZMCT to see anything — run-confirmation is
    impossible on this node. Decisions recorded in DN001 rev 2 / DN002 / ROADMAP
    (deferred to the phase-2 caldaia monitor node).
    Firmware:
    - shared espnow_schema.h: BBU_CT_STATE_* defines, wire value 3 = NOT_FITTED
    (12 B sample layout unchanged)
    - node-bbu: CT_FITTED 0 — monitor skips A0, telemetry ct_state=NOT_FITTED,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
    [comms.h, control.c, control.h, espnow_schema.h, main.c, ui.c, ui.h]
2026-09-01 fix: scan immediately on 3-fail (DN003 rest is between attempts)
    Drill B (BENCH_DROP_PCT=20) recovered 1- and 2-drop sequences; a triple
    drop of seq 383 correctly tripped unreachable. The rescan then looked
    wedged for ~50 s until a typed `comms` — coincidence: go_unreachable
    waited SCAN_REST_MS before the *first* attempt, then 10 s between the
    next three, and attempt 4 bound on cached ch 11 500 ms after the status
    print.
    - go_unreachable: scan now, rest only after a failed attempt
    - HELLO dwell: 20 ms settle + wait for TX callback (fire-and-forget
    HELLOs never reached a gateway sitting on the cached channel)
    - HELLO_ACK with epoch=0 does not bind (ONLINE/unanchored, fifo grows)
    [comms.c]
2026-09-01 close 011 + 013: scan-on-unreachable confirmed on iron (rebind 34–49 ms)
    Cached-channel 3-fail rebind is one dwell (34/43/49 ms); master channel
    hops recovered in 293–840 ms. Epoch-0 HELLO_ACK refused. Overnight drain
    + Drill B already evidenced. Bench master still had DROP_PCT=20 in flash
    which is why 3-fails kept arriving — useful, not a regression.
2026-09-01 close 009: Auto-start on real wells observed; charge-stop desk-proven
    Human fitted NTCs and saw Auto command the pump ON when TPO fell below
    threshold. Stop-when-charged was not waited for on the plant — same
    control.c path already walked on sim + unit tests. 012 keeps an optional
    full-cycle watch, not a blocker.
2026-09-01 docs: 012 is next (menus + boot-mode persistence); 011 client item ticked
    Current node image still boots Manual. Persistence is the 012 pass —
    FIFO is RAM and dies on a blip; last-known mode will not.
2026-09-02 feat(node-bbu): DN002 boot-mode persistence — NVS mode+Manual coil, params autosave
2026-09-02 feat(node-bbu): 012 field-image TFT menus — comms status, AMB, FIFO depth, DN003 param-table editor, comms diagnostics, build stamp
2026-09-02 ui: restore pre-012 Control Prog quick mode/pump toggle rows; docs: bench gotchas (C3 erase_region under NO_STUB)
2026-09-02 ui+serial: soft reboot — two-click confirm row in Diagnostics, serial 'reboot' (NVS state restores via normal boot path)
    [main.c, ui.c]
2026-09-02 fix(ui/stats/wdt): DIAG stack overflow (items[16]->[17]); WDT feed via monitor task + ui stack 12K; persistent pump counters; abbrev Prog names; build alias
    [control.c, control.h, main.c, ui.c]
2026-09-02 fix(wdt): subscribe mon+ui tasks (not app_main's blocked main) — dump spam was wrecking scan dwells
    [main.c, ui.c]
2026-09-02 issue 012: record human HW note — deploy without PPTC (F1), risk accepted
2026-09-02 docs: DN004 addenda (logger GW SoftAP + GPIO2 LED, RF survey) and refined ch-6 gotcha
2026-09-02 issue 012: bench session record — walked/fixed items, deploy readiness notes
2026-09-02 comms: ring default 4096->7680 (DN003 90KB intent) + heap report; capture while comms disabled; scan back-off 10s->1min->10min cap on failed cycles
    [comms.c]
2026-09-02 enc: rate-limit A/B ISR (1 ms min edge) + suppressed counter — bench WDT starvation is an ISR storm from bouncing encoder lines, predates the ring change (06:20 log)
2026-09-02 build: FW alias auto-defaults to git short hash (+-m when dirty); gotchas: encoder ISR storm + A/B caps note
2026-09-02 build: FW alias always forced from git hash (+-m for firmware-dir dirt) — named -D overrides dropped as a cache-staleness footgun
2026-09-02 bench: TWDT panics for real backtraces — TWDT register dumps corrupt on this board (zeroed MSTATUS/MTVEC, missing backtrace), 012 notes
2026-09-02 ui: drop inert CT-wait row (014); Diagnostics gains Boot session row; label Starts as pump starts
2026-09-02 enc: raw (framework-free) ISR + IO-MUX glitch filters on A/B/SW — panic dump showed IDLE starved at interrupt level while ui slept in vTaskDelay; ui: Pump ON/OFF/HALTED on Home
    [enc.c, enc.h, ui.c]
2026-09-02 hardware: schematic v0.09 — encoder A/B/SW caps (bench ISR-storm fix), PPTC F1 omitted (deploy decision 012), CT+snubber already dropped (014); v0.09 exports replace v0.08
    [bbu_controller_prototype.kicad_sch, bbu_controller_prototype_kicad-v0.09-BOM.csv]
2026-09-02 build: build-id header generated per BUILD (gen_build_id.sh + ninja custom target) — CMake-cached alias reached flashed bins stale; sdkconfig picks up bench TWDT panic
2026-09-02 docs: STATUS/ROADMAP/012 reflect 2026-09-02 session 2 — field image complete, WDT root cause + panic trial, v0.09, deploy posture
2026-09-03 enc: poll A/B on the 5 ms timer — drop the GPIO ISR
    Panic trial 2026-09-03 (encoder-provoked, v0.09 caps on): IDLE starved
    while ui sat at jal enc_take_steps. The raw ISR + 1 ms software cap
    still paid entry cost on every chatter edge. Mechanical A/B does not
    need interrupts; the gray-code table already maps bounce to 0.
    Leave CONFIG_ESP_TASK_WDT_PANIC armed for the re-soak. Serial enc now
    reports skip= (invalid gray samples).
    [enc.c, enc.h, main.c]
2026-09-03 ui: vTaskDelay(1) — HZ=100 made pdMS_TO_TICKS(5)==0
    Poll-fix soak still TWDT'd while menu-surfing. Dump: ui had just
    returned from enc_take_hold (innocent). vTaskDelay(0) yields but does
    not block, so prio-1 ui stays Ready and IDLE never runs.
    Also append BBU_PARAM_SAMPLE_PERIOD_S=11 (5..120 s, default 15, NVS
    comms/per). CONFIG_VER 2. Does not touch the params p1 blob. Serial
    tel and Control Prog share the setter. Encoder step 5 s.
    [comms.c, comms.h, espnow_schema.h, main.c, params.c, params.h, ui.c]
2026-09-03 node: field-build fixes — counters checkpoint, clear confirm, ct label, home UTC clock
    Counters were NVS-persisted but only saved on pump stop; the bench pump
    runs continuously so the lifetime total never checkpointed and every
    reflash read as "re-zero". Save every 5 min of pump runtime, and flush
    before the UI DIAG soft reboot (was serial-reboot-only).
    Clear counts is now two-click confirmed (mirrors Reboot). ct_confirm_s
    was mislabeled as a second "dT min" in Control Prog — now "ct wait".
    Home shows UTC date/time (04 Sep 2026 17:57) from the DN003 anchor;
    Pump+Set share row 3. Placeholder until first TIME_SYNC.
    Soak on 5697cef: ~10 min menu abuse + soft reboots, zero TWDT.
    Panic conf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
    [comms.c, comms.h, control.c, control.h, main.c, ui.c]
2026-09-03 params: remove ct_confirm_s — CT defunct in this design (human call)
    Wire id 5 permanently reserved (append-only registry rule, never
    reassigned/renumbered); nothing deployed ever consumed it. CONFIG_VER 3.
    Params NVS blob v2: old p1 rejected, params reset to defaults once
    (counters and boot mode live in separate blobs and survive).
    The warn_noct path keeps DN002 semantics with a fixed internal
    BBU_NOCT_CONFIRM_S 10 window — dead code on CT-less hardware (014),
    retained for bench/history and host tests. Control Prog loses the row.
    [control.c, control.h, espnow_schema.h, params.c, params.h, ui.c]
2026-09-03 deploy: strip CONFIG_ESP_TASK_WDT_PANIC — field image
    Bench-only panic catcher did its job (named the encoder-WDT culprits,
    2026-09-02/03); b749dc3 passed the desk check. A field node must never
    panic-reboot over a transient. TWDT stays armed at 5 s, log-only.
    Re-add recipe kept as a comment in sdkconfig.defaults. Not pushed yet —
    push waits until the deploy image is in hand.
2026-09-03 012 closed: field install 2026-09-03 — node on the wall, controlling
    Deploy image 060c88d pushed before install. Human-confirmed: pump
    control, params persisted through reflash (blob v2 proven in field),
    sane NTCs. Charge-stop cycle watch deferred to the logger (summer).
    015 filed for the field logger gateway; STATUS/ROADMAP updated.
2026-09-04 control law: hysteresis moves to the cooling side (016)
    Field 2026-09-04: pump never stopped with the boiler satisfied at 61 C.
    Old law centered the band: stop threshold setpoint+hyst/2 = 61.5 C sat
    above the boiler's own 61 C limit, and once TPO decayed below it while
    RUNNING, no stop path was reachable at all (livelock).
    New law (per human diagnosis - hysteresis only applies while cooling):
    - stop: min_on && [TPO >= setpoint || cooling backstop] && dT <= delta
    - restart: TPO <= setpoint - hysteresis && min_off
    - cooling backstop: peak-tracked TPO fell back to setpoint - hysteresis
    with dT collapsed => boiler gone, stop (guards the livelock; peak
    tracking prevents warm-up chatter)
    tpo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
    [control.c, control.h, params.c, params.h]
2026-09-04 delta default 5.0 -> 1.5 (016 field debrief); 017 boiler-out warning filed
    Human plant debrief 2026-09-04: the boiler (own limit 61 C, above our
    setpoint) holds fire until return water meets its threshold, so the store
    equalises near the setpoint before the pump should stop - a fully loaded
    tank historically showed TPO ~= TPU within 1 C. Delta 5.0 declared
    "charged" with the bottom still 5 C cooler; 1.5 matches the plant.
    (Existing bounds 0..30 already allow the value; field unit keeps its
    persisted 5.0 until changed in the Control Program menu.)
    Cold-flush start on a stratified tank re-traced through the 016 peak
    tracker: peak resets per cycle and pins at the start TPO (<= restart
    level),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
    [params.c]
2026-09-04 015 design settled: streaming logger-gateway, ack-on-watermark; commit-service DN005 skeleton
    - 015 addendum records the full 2026-09-04 design pass (human-agreed):
    no logger-side durable store (node FIFO is the outage buffer, DN004
    write-through-or-withdraw from birth), BATCH_ACK gated on commit
    watermarks, time = SNTP primary + MQTT time-set fallback + NVS
    checkpoint, channel STA-derived (never hardcoded), LED root-cause
    table (1..5 blinks + frame-flicker overlay), GPIO27 pull-up button
    (LOW-pressed) opening SoftAP bracino-gateway01, bench plan with
    TFT-less/relay-less spare node (stock firmware degrades gracefully).
    - server/: mosquitto config (persistence on, anonymous benc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
2026-09-04 015: field logger-gateway firmware (pass 1) — builds clean on ESP32
    Evolved from bench-espnow-master (013's field-proven wire chassis):
    - DN004 state machine in net.c (WAIT_BACKEND↔ACTIVE, health gate incl.
    commit-service health staleness; ESP-NOW only exists in ACTIVE)
    - commit-watermark-gated BATCH_ACK: ack only when bracino/gateway/commit
    covers batch end_ms (node-clock domain, wrap-safe); retransmitted
    committed batches re-ack immediately; boot_session voids stale state
    - computed per-sample timestamps (DN003): interpolated across declared
    span, last sample = end_ms exactly → watermark coverage is exact;
    DN004 flat JSON telemetry (QoS 0) + capture_ms/batch fields for dedu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
2026-09-04 commit-service: fix dedupe skip to strict <= (equality case), record layer-1 drill results
    Drill-2 replay exposed an off-by-one: skip condition was 'cursor > cap'
    so a sample at capture_ms == cursor slipped through as a duplicate.
    Now skips when wrap_le(cap, cursor). Post-fix verification: full
    overlapping replay produced zero watermarks and zero new lines.
    Also records the accepted crash window (line fsync vs cursor fsync are
    not atomic; Influx idempotence absorbs the rare replay duplicate).
2026-09-05 015: gateway-local exterior ambient (GPIO33 NTC) + broker/NAS deployment notes
    - amb.c: ADC1_CH7 oneshot, 64-sample average, line-fitting calibration
    with rail-referenced fallback; empirical anchor (T0=27C, R0=8100R,
    beta 3950 slope) because the part measures 8.11k at 27C — 17% off a
    nominal 10k spec; open/short reported in-band as faults, never garbage
    - publishes bracino/gateway/telemetry (DN004 addendum: gateway-local
    measurements, QoS 0, non-retained, no watermark involvement; framing
    decision: gateway reports about itself, NOT NODE_TYPE_WEATHER masquerade)
    - LED moved to GPIO16 (GW rev); broker default 192.168.0.215:1883 (NAS)
    - commit service subscribes gw telemetry -> JSON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
    [amb.c, amb.h, main.c, net.c, softap.c]
2026-09-05 015: build fixes for ambient — unit_init_cfg_t type, ADC_ATTEN_DB_12, softap arg order
    [amb.c, softap.c]
2026-09-05 015: re-anchor GW ambient on DVM two-point (beta 3986, R25 ~9.8k) — ADC chain over-reads tap ~6%
    Arduino-sketch-derived anchor (27C, 8100R) was built on the uncalibrated
    ADC chain's over-reading. DVM ice/boil (31.9k @ 0.8C, 686 @ 99.0C) gives
    beta 3986, R(25C) 9.8k: a normal 10k-class part. Divider+sensor good.
2026-09-05 015: fix softAP insta-close — loop-top 'now' predates s_opened_ms
    Long-press iteration: open() blocks ~100-400ms and sets s_opened_ms
    AFTER 'now' was sampled at loop top. The unsigned delta (now -
    s_opened_ms) wraps to ~4e9 > AP_WINDOW_MS, so the auto-window branch
    closed the AP in the same iteration that opened it. Re-sample 'now'
    before the window check.
    [softap.c]
2026-09-05 015: raise httpd request-header buffer to 2048B — browsers got 431
    Desktop browser headers (UA, Accept, sec-ch-*, cookies) exceed the
    512B default scratch buffer; httpd_parse rejected the request with
    431 Request Header Fields Too Large before it ever reached /save.
    Found in GW bench session: tio log 431 at /prov POST.
    [softap.c]
2026-09-05 015 stage A: MQTT auth (gw NVS+prov+serial), t520 compose deploy, NAS IP 192.168.1.215
    - gateway: NVS muser/mpass, /prov fields, serial 'u <user> [pass]' /
    'u -' clear, status page shows user; esp-mqtt credentials wired,
    anonymous fallback when unset (bench drills unaffected)
    - commit_service + fake_publisher: MQTT_USER/MQTT_PASS env / CLI auth
    - commit-service Dockerfile; compose v2: mosquitto(auth'd)+commit
    always, influxdb behind --profile influx for stage C; storage layout
    per 2026-09-05 design (live JSONL local, mirror nas-data2, influx
    nas-data1)
    - mosquitto.conf: container paths, allow_anonymous false, hashed passwd
    - server/README.md = t520 runbook (stage B); DN004 health-s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
2026-09-05 server README: passwd generation — don't drop the command tail, chown 1883 after
2026-09-05 server README: passwd generation needs -it (no stdin attach -> Empty password)
2026-09-05 server README: passwd file — drop chmod, 0600 + uid 1883 is correct as-is
2026-09-05 server README: stage-B gotchas — bind-mount auto-dir trap, passwd -it, ownership
2026-09-05 015: status shows UTC wall time + LED-table health state as text
    's' now prints the gateway's wall clock in human-readable UTC next to
    the time source, and a 'health=' line driven by led_eval() itself (same
    table, same evaluator — the serial view cannot drift from the blink
    view). WiFi channel was already shown as ch=.
    [main.c]
2026-09-05 server README: smoke test must export .env into the shell
    docker compose auto-loads server/.env; an interactive shell does not,
    so the $MQTT_PASS in the stage-B smoke test expanded empty and mosquitto
    correctly refused the anonymous bind. Export before the sub/pub lines.
2026-09-05 housekeeping: ignore generated gateway sdkconfig; KiCad pro-file metadata noise
    - firmware/gateway/sdkconfig is idf.py build output; defaults live in
    sdkconfig.defaults. Ignoring it also un-dirties the build-id alias.
    - bbu_controller kicad_pro: KiCad cleared used_designators on open;
    no netlist/BOM impact (exports unaffected).
2026-09-05 015: session log — t520 stage-B chain verified end-to-end; sim-node bind open
2026-09-06 gw: build id in 's' + status page; slow LED blinks to countable 200ms
    - gen_build_id.sh port from node-bbu 012 (per-build header, not cached
    define — skill gotcha 15); 's' prints fw=<hash> build=<UTC stamp>,
    SoftAP status page gains a firmware row.
    - LED error blinks 150ms->200ms on/off: a 5-blink pattern spans 2.0s,
    countable by eye at the wall unit.
    [main.c, softap.c]
2026-09-06 gw: raw/drop/rssi rx counters in 's' — 'deaf' vs 'rejecting' split
    recv_cb truth before validation: rx_raw counts every ESP-NOW callback,
    rx_drop counts filtered frames (bad len/proto/type), last_rssi from
    rx_ctrl. gw_ct.rx[] only counted accepted messages, so a rejection
    loop looked identical to a deaf radio — bench law: expose driver truth.
    Instrumented for the hel-burst bind hunt; reads 0/0/-1 when idle.
2026-09-06 node: fw hash + build stamp in serial banner and 'st' status
    The hash previously lived only on the TFT System Data screen — invisible
    at the bench where the node runs headless over serial. Boot banner and
    'st' now print fw=<hash> build=<UTC stamp>, same identity as the GW 's'
    line (gen_build_id.sh from 012).
2026-09-06 018: bench C3 TX radiation failure + commissioning RF smoke-test process
    Driver tx_ok is not radiated power for broadcast — two independent
    receivers (GW b34efe9 raw counters, 013 bench-master) deaf to pinned
    hel bursts at cm range. Board tagged DO-NOT-USE; golden-fixture policy
    noted (WROOM bench-master + proven C3 to follow); RF smoke-test against
    golden boards becomes mandatory before any node protocol bring-up.
2026-09-06 amb: ADC channel was GPIO35 (floating), not wired GPIO33; RANGE fault; ext_amb in 's'; 018 closed
    - amb.c configured ADC1_CH7 = GPIO35 on ESP32 — a floating input-only
    pin — while the NTC divider sat on GPIO33 = ADC1_CH5. DVM showed
    2.00 V (~26 C) at the tap while firmware published -31.3 C from the
    ghost channel. Fix: ADC_CHANNEL_5, PIN_NTC cross-referenced.
    - New RANGE fault (t < -20 || t > 60): a floating tap above V_OPEN
    converts to ~-31 C and passed as valid weather (018 lesson, TX-side
    cousin of 'firmware belief vs driver truth'). Fault JSON keeps the
    string schema (OPEN/SHORT/RANGE), names passed through verbatim.
    - 's' now prints ext_amb (was SoftAP-page only; serial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
    [amb.c, main.c]
2026-09-06 amb: fix header comment mangled by channel-fix commit (dangling block)
    [amb.c]
2026-09-06 amb: ACTUALLY switch ADC channel 7 -> 5 (GPIO33)
    The previous commit changed the comments and added the RANGE fault but
    neglected the two ADC_CHANNEL_7 references — firmware kept sampling
    GPIO35 (floating), now honestly reported as RANGE instead of -31.3 C.
    Caught because the RANGE guard flagged the ghost reading on the bench.
    Same class of failure as 013's stale-alias bin: claimed fix not present
    in the artifact. Verify the patch hunk, not the commit message.
    [amb.c]
2026-09-06 amb: 's' healthy line shows tap mV too (ext_amb_mV=) — DVM cross-check on the bench
2026-09-06 amb: document NTC placement requirement — bead must be thermally free of the PCB
2026-09-06 docs: STATUS + ROADMAP to 2026-09-06 reality — 015 chain field-ready, GW deployed
    STATUS: new 015/018 section (t520 stage B verified, first real GW↔node
    bind, GW fix list incl. ADC ch5 + RANGE guard, commissioning RF
    smoke-test mandate, JSONL ~1.7 MB/day); 'What works' table un-staled
    (gateway/MQTT/commit-service/compose/retention rows). ROADMAP: gateway,
    MQTT publish, and commit-service stage-B milestones checked; 015 line
    reflects deployment; stage C notes JSONL compresses ~10x.
2026-09-06 commit-service: reopen JSONL per write — mv/deletion/rotation can't orphan writes
    Held one startup handle; when the log file was mv'd (2026-09-06, first
    boiler-room drain), acks kept flowing into the renamed inode and the
    canonical path never re-appeared. Now open-append-fsync-close per line:
    the fsync dominates, so the fresh handle is free, and stage-C rotation
    can treat the log as a normal file. Smoke-tested: rename + next write
    re-creates the file at the canonical path.
2026-09-07 node-gone detection chain + restore_time fix + EVENT capture_ms
    - GW net.c: restore_time() from epoch_s alone (u32 uptime-delta
    underflow killed; DN004 amended). Fixes the 05 Sep garbage-anchor
    window that poisoned node timestamps.
    - GW main.c: publish retained bracino/node/<t>/<id>/status
    online/offline on unreach raise/clear (issue 021).
    - GW main.c: EVENT frames parse TLV_EVENT_CAPTURE_MS and stamp
    node_ts via anchor arithmetic (issue 020).
    - node comms.c: EVENT queue 8->24, offer-time capture_ms stamped
    into every event; DN003 amended.
    - commit-service: node status + GW LWT subscriptions -> retained
    bracino/alarm (node_gone/node_back/gateway_gone) + optional
    NTFY_URL push (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
    [comms.c, espnow_schema.h, main.c, net.c]
2026-09-07 AGENTS.md: session-end handoff protocol clarified + Language Lock
    Session-end agent behavior was ambiguous and got run backwards once
    (2026-09-07): the current status belongs on the live pad at session
    END; the .bak is written only at session START (backup of what was
    ingested). Also includes the standing Language Lock local edit.
2026-09-08 build: gen_build_id header as declared OUTPUT + OBJECT_DEPENDS
    ELF-only ordering let the header be rewritten just before link while
    objects compiled in a prior build passed the staleness check — every
    build shipped the previous build's identity strings (field flash today
    booted b36a268-m/0937 while build/bracino_build_id.h said 69e43a8/0943).
    Now: header is a custom-command OUTPUT with an ALL target (per-build
    refresh preserved), and the sources embedding it (node: main.c ui.c;
    gateway: main.c softap.c) carry OBJECT_DEPENDS so they always compile
    after the header is fresh. Verified: both bins embed the current
    build's stamp and hash, and the -m dirty flag still tracks the
    firmware dirs.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
2026-09-08 gateway: 4MB flash + custom 3M app partition
    flash_id at the bench confirmed 4MB (ESP32-D0WD-V3) — sdkconfig's 2MB
    was a project-creation default. The stock single-app 1M factory
    partition left the 1013K bin at 97%; stock singleapp_large only offers
    1500K. Custom partitions.csv grows factory to 3M while keeping the head
    layout byte-identical (nvs@0x9000 24K, phy@0xf000 4K, app@0x10000), so
    the one-time pt+app rewrite preserves NVS (wifi creds, epoch_s, params).
    Bin now at 33% of its partition. (sdkconfig is generated, hence not in
    this commit.)
    [partitions.csv]
2026-09-08 hardware: worktree reorg — bbu-controller split into node-bbu + gateway KiCad projects
    - hardware/node-bbu/: v0.09 controller schematic/PCB as renamed from
    hardware/bbu-controller (same BOM/ERC/NETLIST exports)
    - hardware/gateway/: gateway_protoype v0.01 project with BOM/ERC/NETLIST
    - old hardware/bbu-controller/ tree removed (README + pin-mapping csv
    deleted; AGENTS.md pointer to the csv is now stale)
    - .history/ and *.kicad_prl excluded via .gitignore
    Schematics represent both protoboards now running in the field.
    [bbu_controller_prototype_kicad.kicad_sch, gateway_protoype-v0.01-BOM.csv, gateway_protoype.kicad_pcb, gateway_protoype.kicad_sch, module_pin_mapping_bbu_controller_prototype.csv, node-bbu-v0.09-BOM.csv, node-bbu.kicad_pcb, node-bbu.kicad_sch]
2026-09-08 gateway: show firmware identity on the provisioning page
    /prov now prints 'firmware <name> (build <stamp>)' below the form, so a
    flash can be confirmed from a phone browser instead of a serial
    monitor. The status page already carried the same line.
2026-09-08 hardware: reorg round 2 — kicad projects into *_kicad/ dirs, restore node-bbu refs
    - gateway_protoype/ -> gateway_protoype_kicad/
    - node-bbu sources -> node-bbu-prototype-kicad/
    - restore module_pin_mapping csv (AGENTS.md pointer stays valid) and
    the (stale, historical) node-bbu README
    [gateway_protoype-v0.01-BOM.csv, gateway_protoype.kicad_pcb, gateway_protoype.kicad_sch, module_pin_mapping_bbu_controller_prototype.csv, node-bbu-v0.09-BOM.csv, node-bbu.kicad_pcb, node-bbu.kicad_sch]
2026-09-08 issue 015 closed: field logger gateway shipped + field-verified
    All Expected boxes checked 2026-09-08 on human confirmation: LED
    patterns, RF channels (1/11 good, 6 ruled out), install-day drain in
    the record, ~a dozen pump charge/stop cycles in 2.5 days, firmware
    home in firmware/gateway/, fsync-gated ack chain proven in 013 drills.
    Residual supervision drills stay in 021; stage-C influx tracked via
    server/README + 008.
2026-09-08 issue 015: record-hygiene note — bench drills interleaved in the JSONL
    Boot tags 92/170 are bench bring-up sessions (MANUAL, room temps,
    fault-injection events incl. the never-cleared F2 @ 2026-09-06T16:23Z).
    Also documents the post-reboot AMB artifact: reads ~1-1.5 C low for
    ~10-15 min (cold board self-heating recovery) — discount after any
    boot-session change.
2026-09-08 issue 022: AMB step-down at node reboot — phenomenon established, mechanism open
    Downtime-scaled AMB step at every reboot (−0.2 to −1.4 C, 10-15 min
    recovery). AMB-channel-specific (TPO/TPU show only natural drift);
    not normal room dynamics (Sep-7 zero-reboot day: <=0.8 C max per 6 min).
    NTC divider self-heating ruled out by physics; enclosure-coupling
    doubted but untested. Bench sweep folds into 019's sag work.
2026-09-08 commit-service: stage-C Influx tailer (env-gated, non-blocking, idempotent)
    INFLUX_TOKEN set -> daemon thread projects the JSONL into Influx line
    protocol (measurements telemetry/event/gw_ambient; timestamps from each
    record's own stamp, so re-tails overwrite identical points). Offset
    persisted in influx_tail.json; rotation/truncation resets it. Write
    failures retry with backoff and never touch the ack path; health on
    bracino/backend/influx (retained, 30s), commit-path health unchanged.
    Unset token = pre-stage-C behavior.
    compose: INFLUX_URL/ORG/BUCKET/TOKEN env on commit. README: stage-C
    section rewritten as deployed-state contract; notes GW ext-ambient
    misrange before 2026-09-06T14:49Z (j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
2026-09-08 issue 022 closed: AMB steps dissolved — door entries, not a sensor artifact
    Boot-session markers let the human reconstruct the Sep-8 morning: every
    reboot was user-attended (phone / laptop visits), AMB drops were door
    openings confirmed repeatedly without reboots, and the only real
    post-boot artifact is a ~0.3 C, <1 min TPO/TPU warm-up transient.
    Bench sweep cancelled by human; reboot-cluster size noted, not chased.
    015 record-hygiene note corrected accordingly.
2026-09-08 tools/: promote telemetry plotter from ephemera — canonical forensics aid
    Headless + interactive (--show) JSONL plotter: TPO/TPU + AMB (node & GW
    probes), relay shading, fault-event markers, boot-session start markers,
    auto line-breaks at gaps and boot changes (interleaved bench streams
    never connect). Proven in 019/022 forensics; parses the DN005 JSONL
    contract, so it versions with it. ephemera/ copies remain scratch.
2026-09-09 issues: close 016 (field-verified from Sep 5-8 record); file 023 boot-session NVS counter; 019 brownout-signature addendum
    016: law verified in the trusted region (stops 57.9-58.0 dT<=1.4,
    restarts 53.1-54.0, no chatter, solar hold-off correct). Residual
    bound corrected to <=2 spurious pairs/night, sustain-arm not built.
    Post-stop TPO spike re-attributed to brownout (human), not soak.
    023: boot_session is esp_random()&0xFF u8 today - random tags collided
    (92 used by bench AND field). Proposal: monotonic u32 NVS counter,
    firstboot=1, rides next routine reflash.
2026-09-09 issues/023: refine per human — keep u8 (wrap is benign), continuity via serial boot_id param after erase_flash, no schema-width change
2026-09-09 tools/plotter: window-filter gw_ambient vs --start/--end; gray pump on/off edge lines + spans; file 024 (post-stop TPU plunge, deferred) + 025 (notifier rules); 023 erase-flash runbook note
2026-09-09 node: boot_session becomes a monotonic NVS counter (023)
    First boot = 1, increments every boot, wraps 255->1 (benign: dedupe
    compares against latest session only). Replaces esp_random u8 tags
    whose collisions (tag 92 used twice) poisoned record provenance.
    - schema: BBU_PARAM_BOOT_ID id 12 (SET seeds NEXT boot for erase_flash
    reseed; GET = current id), BBU_CONFIG_VER 3 -> 4
    - comms.c: load-increment-persist at init; comms_set_boot_id_next();
    esp_random.h include dropped
    - main.c ext hooks + params.c table entry (serial boot_id N)
    - DN003: counter semantics + registry addition; runbook: post-erase
    reseed step (reseed -> verify TFT -> comms ON last; GW-down fallback)
    - 023 status: imple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
    [comms.c, comms.h, espnow_schema.h, main.c, params.c]
2026-09-10 016 addendum: backstop double-stops can fire mid-cycle, not only overnight
    Post-outage morning cycle (boot 213, 2026-09-10): two backstop
    stop/restart pairs while the tank hovered at the restart level before
    the boiler contributed; cycle then charged cleanly to setpoint. Bound
    reworded as <=2 pairs per hover per loading cycle. Includes
    chart-reading note: mid-run TPU sag with relay ON = ACS unloading at
    mid-strata, not a relay edge.
2026-09-10 server: grafana service + provisioned datasource/starter dashboard
    grafana/grafana:13.0.2 behind profile 'grafana', port 3000, data on
    nas-data1. InfluxDB-Bracino datasource (flux, token from .env) and a
    starter bbu-overview dashboard (TPO/TPU, relay state timeline, GW
    ambient) provisioned from server/grafana/. README bring-up section
    updated (grafana no longer desktop-only); STATUS/ROADMAP bumped.
    Events/annotations per DN006 still open.
2026-09-10 grafana starter: simple legend labels (TPO/TPU/Pump relay/Ambient), boot colors kept
    Legend strings were raw flux series ('t_tpo {boot_session=..., mode=...}').
    Map _field to friendly names in flux, keep one frame per boot_session
    (preserves per-boot color separation), drop other tags from the frames so
    the legend suffix is gone. Tooltip still shows everything.
2026-09-10 grafana starter: hide x-axis on pump-relay strip
    Grafana has no native date-on-change tick format for multi-day windows;
    the relay strip repeats 'MM/DD HH:mm' on every tick. Hide its axis and
    let the temps panel above carry it (shared crosshair keeps alignment).
2026-09-10 grafana starter: aligned axes, time-only ticks env, AMB overlay
    - fixed axisWidth 55 on all three panels + short relay row labels
    (boot N) so plot areas share the same left offset and the shared
    crosshair line is continuous across panels
    - GF_DATE_FORMATS_INTERVAL_HOUR=HH:mm: time-only x ticks (multi-day
    windows otherwise repeat MM/DD HH:mm on every tick)
    - ambient panel overlays node PCB t_amb with gw_ambient t_amb
2026-09-11 026: node->gw ESP-NOW delivery outages diagnosed from Sep-10/11 record
    Gaps are delivery outages with full ring backfill (boot 213, capture_ms
    monotonic, zero sample loss) - not brownout, not node silence. Windows
    correlate with commit-service GONE/CLEARED alarms; gw ambient + MQTT
    stayed up in most, so failure is node<->gw radio. Two populations:
    short rebinds (3-8 min) and long stalls (28-69 min). The 11:52Z event
    was a real gw WiFi/MQTT stall; its gateway_gone LWT alarm never fired
    (payload drift - fixed separately in 027).
2026-09-11 027: link instrumentation (node LINK events, gw-016 status JSON) + 021 LWT fix
    Measurement-only, fix decision deferred (026 theory-1: gw health gate
    tears down ESP-NOW on a single failed check; node scan backoff amplifies
    into ~40 min naps):
    - schema: EVENT_LINK_SCAN 0x06 (consec_fail, last_ch, tx_fail, retrans),
    EVENT_LINK_BIND 0x07 (channel, scan_fails); ring-backed, arrive in the
    outage backfill dump
    - node comms.c: offer both at unreachable->scan and bind
    - gateway: decode both; net.c publishes retained status JSON on
    WAIT_BACKEND/ACTIVE transitions + every 30 s (mode, legs, RSSI,
    channel) as gw-016; LWT msg_len 18->16 (was over-reading the literal)
    - commit-service: alarms on e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
    [comms.c, espnow_schema.h, main.c, net.c]
2026-09-12 027 follow-up: persist gw status heartbeats to JSONL + influx (rssi time series)
    gw-016 heartbeats (30 s, retained) were logged on marker change only —
    no gw->AP rssi_dbm trace existed for 026 outage adjudication. Now one
    kind:gw_status JSONL record per heartbeat; influx measurement gw_status
    (tag mode, int fields legs/rssi/channel/uptime). DN004 presence section
    notes the contract; 027 addendum records the decision.
2026-09-12 021/023/027: field drill results 2026-09-12 — LWT chain first positive test, boot counter increments, LINK events first field capture
